brainboxemb/2026-009-01.cad.HUB75-display-frame/doc/README.md

# HUB75 display-frame documentation

This directory is the maintained project-documentation index.

## Reading order

- [10-00 — Plan](10-00-plan.md) — current gate, sequencing and project status.
- [20-00 — Manuals](20-00-manuals.md) — practical development and user guidance.
- [20-01 — Development](20-01-development.md) — maintain, qualify and release the project.
- [20-02 — User](20-02-user.md) — inspect/build the current display-frame.
- [30-00 — Specification](30-00-specification.md) — project intent and ownership.
- [40-00 — Design](40-00-design.md) — application architecture and coordinate model.
- [50-00 — Verification](50-00-verification.md) — digital/physical acceptance boundaries.

Detailed component construction remains beside source in component-local
`design/design.md` files. Physical procedures remain under
[../vrf/physical/](../vrf/physical/README.md).
