brainboxemb/2026-009-01.cad.HUB75-display-frame/vrf/templates/README.md

# HUB75 display-frame verification

Repository-level strategy/status: [30-verification.md](30-verification.md).

Verification evidence is deliberately separate from normal build output.

The build branch answers **what is built**. This verification branch answers
**whether the current connector-family geometry fits the HUB75 panel model as
intended**.

Normal standalone component renders and production STL exports remain under
`bld/` and are intentionally not duplicated in this snapshot. The verification
snapshot contains only fit/section evidence plus publication provenance.

## Contents

- [PNG verification gallery](png/README.md)

## Components

### Middle coupler

Joins two adjacent panels at the middle mounting row. Each small/medium/large
size publishes an angled local fit view, a size-aware rear fit section and an
XY seam section.

### Horizontal-edge coupler

Joins the same panel seam at the top/bottom display edge. The core fit evidence
remains intentionally independent of the tube-mount layer so physical panel
acceptance can still evaluate the accepted panel-facing geometry.

Each small/medium/large size publishes an angled top-edge fit detail, a
size-aware rear fit section, a YZ end-rail profile and an orthogonal XY seam
profile through the vertical arm.

### Corner-edge couplers

The corner family has two printable parts:

- left = top-left and, after 180 degree rotation, bottom-right;
- right = top-right and, after 180 degree rotation, bottom-left.

Each side and size publishes:

- angled one-panel corner fit detail;
- size-aware rear fit section through the rounded rear corner opening;
- a 0.10 mm YZ top-edge technical slice;
- a 0.10 mm XY side-edge technical slice.

In addition, each size publishes two canonical readable profile sections shared
by left/right because the two interfaces are mirrored equivalents:

- horizontal profile section through the top arm;
- vertical profile section through the side arm.

These canonical 0.50 mm profile sections retain the complete panel profile with
the red corner coupler around it, matching the presentation style used for the
horizontal-edge profile sections.

The core corner-fit evidence remains independent of the reinforcement layer.

### Tube-mount coupler and canonical clamp

The tube-mount layer uses one canonical separate printable tube clamp built from
the public `lib.scad.clamps` tube-clamp body plus the standard locked
sliding-dovetail interface from the pinned `lib.scad.mechint` revision.

For each small/medium/large coupler size, the same clamp is used and the
verification snapshot publishes:

- an assembled local view containing horizontal-edge tube-mount coupler,
  detachable clamp and Ø10 aluminium tube;
- a thin YZ section through the dovetail engagement, generated with
  `lib.scad.util`;
- a thin XY section through the integral threshold/recess/spring lock.

These views establish digital placement and engagement only. Sliding force,
printer/material tolerance and repeated removal remain physical checks.

## Selective verification

The OpenSCAD evidence above is built by the dependency-aware verification target
engine from `vrf/openscad`. It uses a cache separate from normal Build output, so
an unchanged middle or horizontal verification target can be reused when only a
corner dependency changes. The project-specific verification scripts retain only
interactive-entrypoint smoke checks, output validation and README generation.

## Rear fit sections

The section plane is kept inside the active guide: **3 mm** for the small
4 mm guide and **5 mm** for medium/large.

- grey = real HUB75 rear structural geometry;
- red = only coupler material reaching into the same retained volume;
- blue = Ø2 verification datum pin through the connector's engraved `+`,
  normal to the panel plane.

## Acceptance

These images are digital verification evidence, not proof of a physical print
fit. Production STLs are supplied by the normal Build and still need a real-panel
fit check before a connector-family milestone is considered physically accepted.
