brainboxemb/2026-009-01.cad.HUB75-display-frame/vrf/templates/png/README.md

# Connector verification renders

All verification renders use unique filenames so component and size variants
can be compared directly without navigating through separate directories.
Normal standalone component renders are intentionally kept in the Build output
instead of being duplicated here.

## Reading the section views

Project coordinates are:

| Axis | Direction |
| --- | --- |
| X | horizontal across the display |
| Y | panel front → rear |
| Z | vertical |

Section orientation follows the retained plane:

| Plane | Normal / section axis |
| --- | --- |
| XY | Z |
| YZ | X |
| XZ / rear-facing | Y |

Unless explicitly described as a retained volume, **position** below is the
centre of the section slab and **thickness** is the retained slab thickness.
The implementation may therefore use `position = centre - thickness / 2`
with `direction = "Positive"`.

The HUB75 rear mounting plane is at **Y = 14.50 mm**. Rear-fit positions are
described relative to that datum as well as by their absolute Y coordinate.

# Middle coupler

## Section geometry

| View | Orientation | Position | Thickness / depth | Purpose |
| --- | --- | --- | --- | --- |
| Rear fit — small | XZ, normal Y | cutoff Y = 11.50 mm | 3.00 mm inward from mounting plane; retained rear volume rather than a thin slice | Shows panel/coupler overlap behind the mounting plane |
| Rear fit — medium / large | XZ, normal Y | cutoff Y = 9.50 mm | 5.00 mm inward from mounting plane; retained rear volume rather than a thin slice | Same rear-interface check at the deeper guide presets |
| XY seam — small | XY, normal Z | centre Z ≈ -18.241 mm | 0.50 mm | Slice through the vertical seam below the horizontal arm |
| XY seam — medium | XY, normal Z | centre Z ≈ -20.241 mm | 0.50 mm | Same seam slice for the medium arm height |
| XY seam — large | XY, normal Z | centre Z ≈ -22.241 mm | 0.50 mm | Same seam slice for the large arm height |
| Angled fit | 3D view | — | — | Local visual fit context; not a section |

The middle XY position is derived from
`-hub75_middle_coupler_horizontal_arm_height(coupler) / 2 - 6 mm`, so it
tracks the selected coupler preset rather than using one hard-coded Z value.

## Small

Middle small rear fit

Middle small XY seam

Middle small angled fit

## Medium

Middle medium rear fit

Middle medium XY seam

Middle medium angled fit

## Large

Middle large rear fit

Middle large XY seam

Middle large angled fit

# Horizontal-edge coupler

## Section geometry

| View | Orientation | Position | Thickness | Purpose |
| --- | --- | --- | --- | --- |
| Rear fit — small | XZ, normal Y | centre Y = 11.50 mm | 0.10 mm | Thin rear-interface slice, 3 mm inward from the mounting plane |
| Rear fit — medium / large | XZ, normal Y | centre Y = 9.50 mm | 0.10 mm | Thin rear-interface slice, 5 mm inward from the mounting plane |
| YZ edge profile | YZ, normal X | centre X = 12.00 mm | 0.50 mm | Cross-section through the right panel rear end rail near the seam |
| XY seam profile | XY, normal Z | centre Z = 138.00 mm | 0.50 mm | Section 22 mm inward from the nominal top edge at Z = 160 mm |
| Angled fit | 3D view | — | — | Local visual fit context; not a section |

## Small

Horizontal edge small rear fit

Horizontal edge small YZ edge profile

Horizontal edge small XY seam profile

Horizontal edge small angled fit

## Medium

Horizontal edge medium rear fit

Horizontal edge medium YZ edge profile

Horizontal edge medium XY seam profile

Horizontal edge medium angled fit

## Large

Horizontal edge large rear fit

Horizontal edge large YZ edge profile

Horizontal edge large XY seam profile

Horizontal edge large angled fit

# Corner-edge couplers

## Section geometry

The canonical profile views use the left/top corner as their reference. The
left/right fit views then show the mirrored physical corner positions.

| View | Orientation | Position | Thickness | Purpose |
| --- | --- | --- | --- | --- |
| Canonical horizontal profile | YZ, normal X | centre X = -60.00 mm | 0.50 mm | 20 mm inward from the nominal left edge at X = -80 mm |
| Canonical vertical profile | XY, normal Z | centre Z = 140.00 mm | 0.50 mm | 20 mm inward from the nominal top edge at Z = 160 mm |
| Rear fit — small | XZ, normal Y | centre Y = 11.50 mm | 0.10 mm | Thin corner rear-fit slice, 3 mm inward from mounting plane |
| Rear fit — medium / large | XZ, normal Y | centre Y = 9.50 mm | 0.10 mm | Thin corner rear-fit slice, 5 mm inward from mounting plane |
| Left YZ top-edge | YZ, normal X | centre X = -60.00 mm | 0.10 mm | 20 mm inward from the top-left corner |
| Right YZ top-edge | YZ, normal X | centre X = +60.00 mm | 0.10 mm | Mirrored 20 mm inward slice at the top-right corner |
| Left / right XY side-edge | XY, normal Z | centre Z = 140.00 mm | 0.10 mm | 20 mm inward from the top edge |
| Angled fit | 3D view | — | — | Local visual corner-fit context; not a section |

## Small

### Canonical profiles

Corner small horizontal profile

Corner small vertical profile

### Left

Corner left small rear fit

Corner left small YZ top-edge slice

Corner left small XY side-edge slice

Corner left small angled fit

### Right

Corner right small rear fit

Corner right small YZ top-edge slice

Corner right small XY side-edge slice

Corner right small angled fit

## Medium

### Canonical profiles

Corner medium horizontal profile

Corner medium vertical profile

### Left

Corner left medium rear fit

Corner left medium YZ top-edge slice

Corner left medium XY side-edge slice

Corner left medium angled fit

### Right

Corner right medium rear fit

Corner right medium YZ top-edge slice

Corner right medium XY side-edge slice

Corner right medium angled fit

## Large

### Canonical profiles

Corner large horizontal profile

Corner large vertical profile

### Left

Corner left large rear fit

Corner left large YZ top-edge slice

Corner left large XY side-edge slice

Corner left large angled fit

### Right

Corner right large rear fit

Corner right large YZ top-edge slice

Corner right large XY side-edge slice

Corner right large angled fit

# Tube-mount coupler and canonical clamp

The clamp is one canonical part for all three coupler presets. The section
position changes only because the small coupler uses a different clamp location.

## Section geometry

| View | Orientation | Position | Thickness | Purpose |
| --- | --- | --- | --- | --- |
| Clamp fit | 3D view | clamp centre X = 18 mm small; 25 mm medium / large | — | Shows the complete local tube-mount, clamp and Ø10 aluminium tube |
| YZ dovetail section — small | YZ, normal X | centre X = 18.00 mm | 0.20 mm | Section through the centre of the local dovetail engagement |
| YZ dovetail section — medium / large | YZ, normal X | centre X = 25.00 mm | 0.20 mm | Same section at the common medium/large clamp position |
| XY lock section | XY, normal Z | centre Z = 10.00 mm | 0.20 mm | Shows the lib.scad.mechint ramped threshold, male recess/release and female spring tongue |

The implementation starts these 0.20 mm slabs half a section thickness before
the listed centre and retains them in the positive section-axis direction.

## Small

Small tube-mount coupler with canonical clamp

Small tube-mount coupler YZ section

Small tube-mount coupler lock section

## Medium

Medium tube-mount coupler with canonical clamp

Medium tube-mount coupler YZ section

Medium tube-mount coupler lock section

## Large

Large tube-mount coupler with canonical clamp

Large tube-mount coupler YZ section

Large tube-mount coupler lock section
