brainboxemb/2026-009-01.cad.HUB75-display-frame/docs/01-project-plan.md

# HUB75 display-frame project plan

The project plan moved to [../doc/00-plan.md](../doc/00-plan.md) during
Migration 010 so the project has one operational plan authority.
This file remains only as a compatibility pointer for older links.
