brainboxemb/2026-009-01.cad.HUB75-display-frame/docs/00-new-chat-handoff.md

# New chat / project handoff

This historical entrypoint is retained for compatibility.
Start with [../doc/00-plan.md](../doc/00-plan.md), which now owns the durable
fresh-session working method, current project position and forward plan.

Shared working guidance comes from
[brainboxemb.meta/AGENTS.md](https://github.com/brainboxemb/brainboxemb.meta/blob/main/AGENTS.md).
Do not maintain a second copy/paste workflow here.
