brainboxemb/2026-009-01.cad.HUB75-display-frame/vrf/openscad/corner-edge-coupler-horizontal-profile-section.scad

// Canonical YZ profile through the top/horizontal corner arm.

use <../../dsg/openscad/assemblies/verification/corner_edge_coupler_profile_sections.scad>
use <../../dsg/openscad/ext/lib.scad.hub75/openscad/p5-64x32-panel/hub75_p5_64x32_panel.scad>
use <../../dsg/openscad/components/hub75/corner-edge-coupler/hub75_corner_edge_coupler.scad>

size = "medium";
side = "left";

panel_obj = hub75_p5_64x32_panel_create();
coupler_obj = hub75_corner_edge_coupler_create_for_size(
    side = side,
    size = size,
    panel_obj = panel_obj
);
corner_x = -hub75_p5_64x32_panel_nominal_width(panel_obj) / 2;
corner_z = hub75_p5_64x32_panel_nominal_height(panel_obj) / 2;
slice_inward = 20;
slice_x = corner_x + slice_inward;

$vpt = [slice_x, 7, corner_z - 35];
$vpr = [0, 90, 0];
$vpd = 205;

hub75_corner_edge_coupler_horizontal_profile_section(
    side = side,
    panel_obj = panel_obj,
    coupler_obj = coupler_obj,
    slice_inward = slice_inward
);
