brainboxemb/2026-009-01.cad.HUB75-display-frame/vrf/openscad/corner-edge-coupler-left-rear-fit-section.scad

// Rear-facing top-left corner fit section.

use <../../dsg/openscad/assemblies/verification/corner_edge_coupler_fit_assembly.scad>
use <../../dsg/openscad/ext/lib.scad.hub75/openscad/p5-64x32-panel/hub75_p5_64x32_panel.scad>
use <../../dsg/openscad/components/hub75/corner-edge-coupler/hub75_corner_edge_coupler.scad>

size = "medium";

panel_obj = hub75_p5_64x32_panel_create();
coupler_obj =
    hub75_corner_edge_coupler_create_for_size(
        side = "left",
        size = size,
        panel_obj = panel_obj
    );

section_depth =
    min(5.0, max(1.0, coupler_obj.guide_height - 1.0));

corner_x =
    -hub75_p5_64x32_panel_nominal_width(panel_obj) / 2;
corner_z =
    hub75_p5_64x32_panel_nominal_height(panel_obj) / 2;

// Centre on the complete coupler, including its outside projection.
view_inward = (hub75_corner_edge_coupler_inward_reach(coupler_obj)
    - coupler_obj.outside_projection) / 2;
$vpt = [corner_x + view_inward, 9.5, corner_z - view_inward];
$vpr = [90, 0, 180];
$vpd =
    size == "small" ? 190
    : size == "large" ? 255
    : 220;

hub75_corner_edge_coupler_rear_fit_section(
    side = "left",
    panel_obj = panel_obj,
    coupler_obj = coupler_obj,
    depth = section_depth
);
