brainboxemb/2026-009-01.cad.HUB75-display-frame/vrf/openscad/corner-edge-coupler-right-xy-side-edge-section.scad

// XY side-edge fit section for the top-right corner.

use <../../dsg/openscad/assemblies/verification/corner_edge_coupler_fit_assembly.scad>
use <../../dsg/openscad/ext/lib.scad.hub75/openscad/p5-64x32-panel/hub75_p5_64x32_panel.scad>
use <../../dsg/openscad/components/hub75/corner-edge-coupler/hub75_corner_edge_coupler.scad>

size = "medium";
side = "right";

panel_obj = hub75_p5_64x32_panel_create();
coupler_obj = hub75_corner_edge_coupler_create_for_size(side = side, size = size, panel_obj = panel_obj);
corner_x = (1) * hub75_p5_64x32_panel_nominal_width(panel_obj) / 2;
corner_z = hub75_p5_64x32_panel_nominal_height(panel_obj) / 2;
slice_inward = 20;
slice_z = corner_z - slice_inward;

$vpt = [corner_x + (-1) * 20, 7, slice_z];
$vpr = [0, 0, 0];
$vpd = size == "small" ? 150 : size == "large" ? 215 : 180;

hub75_corner_edge_coupler_xy_side_edge_section(
    side = side,
    panel_obj = panel_obj,
    coupler_obj = coupler_obj,
    slice_inward = slice_inward,
    slice_thickness = 0.10
);
