brainboxemb/2026-009-01.cad.HUB75-display-frame/vrf/openscad/horizontal-edge-coupler-fit-detail.scad

// Angled two-panel top-edge context for horizontal-edge verification.

use <../../dsg/openscad/assemblies/verification/horizontal_edge_coupler_fit_assembly.scad>
use <../../dsg/openscad/components/hub75/horizontal-edge-coupler/hub75_horizontal_edge_coupler.scad>

size = "medium";

$vpt = [0, 14, 115];
$vpr = [78, 0, 220];
$vpd = 260;

coupler_obj =
    hub75_horizontal_edge_coupler_create_for_size(
        size = size
    );

hub75_horizontal_edge_coupler_fit_detail(
    coupler_obj = coupler_obj
);
