brainboxemb/2026-009-01.cad.HUB75-display-frame/vrf/openscad/horizontal-edge-tube-mount-clamp-fit.scad

// Focused assembled view of a tube-mount coupler with the canonical clamp.

use <../../dsg/openscad/assemblies/verification/hub75_tube_horizontal_edge_fit_assembly.scad>

size = "medium";

$vpt = [28, -2, 8];
$vpr = [68, 0, 35];
$vpd = 125;

hub75_tube_horizontal_edge_fit_assembly(
    size = size
);
