brainboxemb/2026-009-01.cad.HUB75-display-frame/vrf/openscad/middle-coupler-rear-fit-section.scad

// File: middle-coupler-rear-fit-section.scad
//   Rear-facing 5 mm fit section through the panel/coupler interface.

use <../../dsg/openscad/assemblies/verification/middle_coupler_fit_assembly.scad>
use <../../dsg/openscad/components/hub75/middle-coupler/hub75_middle_coupler.scad>

size = "medium";

$vpt = [0, 9.5, 0];
$vpr = [90, 0, 180];
$vpd = 210;

coupler_obj = hub75_middle_coupler_create_for_size(size = size);
section_depth =
    min(5.0, max(1.0, coupler_obj.guide_height - 1.0));

hub75_middle_coupler_rear_fit_section(
    coupler_obj = coupler_obj,
    depth = section_depth
);
