brainboxemb/2026-009-01.cad.HUB75-display-frame/vrf/openscad/middle-coupler-xy-seam-section.scad

// File: middle-coupler-xy-seam-section.scad
//   True XY section below the horizontal rib, through the seam locator.

use <../../dsg/openscad/assemblies/verification/middle_coupler_fit_assembly.scad>
use <../../dsg/openscad/components/hub75/middle-coupler/hub75_middle_coupler.scad>

size = "medium";

$vpt = [0, 7, -20];
$vpr = [0, 0, 0];
$vpd = 185;

coupler_obj = hub75_middle_coupler_create_for_size(size = size);
hub75_middle_coupler_fit_cross_section(coupler_obj = coupler_obj);
