brainboxemb/2026-009-01.cad.HUB75-display-frame/dsg/openscad/assemblies/display_frame_assembly.scad

// File: display_frame_assembly.scad
//   Complete display overview with couplers and detachable tube-mount layer.

use <../ext/lib.scad.hub75/openscad/p5-64x32-panel/hub75_p5_64x32_panel.scad>
use <../ext/lib.scad.forge/openscad/resolution.scad>
use <../ext/lib.scad.forge/openscad/transform.scad>
use <../components/aluminium_tube.scad>
use <panels_assembly.scad>
use <helpers/reference_box.scad>
use <../components/hub75/middle-coupler/hub75_middle_coupler.scad>
use <../components/hub75/horizontal-edge-coupler/hub75_horizontal_edge_coupler.scad>
use <../components/hub75/corner-edge-coupler/hub75_corner_edge_coupler.scad>
use <../project_components/tube_mount/horizontal-edge-coupler/hub75_tube_horizontal_edge_coupler.scad>
use <../project_components/tube_mount/corner-edge-coupler/hub75_tube_corner_edge_coupler.scad>
use <../project_components/tube_mount/tube-clamp/hub75_tube_clamp.scad>
use <../project_components/tube_mount/tube_mount_interface.scad>

function _hub75_display_frame_panel_pitch_x(panel_obj) =
    hub75_p5_64x32_panel_nominal_width(panel_obj);

function _hub75_display_frame_half_height(panel_obj) =
    hub75_p5_64x32_panel_nominal_height(panel_obj) / 2;

function _hub75_display_frame_half_width(panel_obj, panel_count = 5) =
    panel_count * _hub75_display_frame_panel_pitch_x(panel_obj) / 2;

function _hub75_display_frame_seam_x(panel_obj, seam_index, panel_count = 5) =
    -_hub75_display_frame_half_width(panel_obj, panel_count)
    + (seam_index + 1) * _hub75_display_frame_panel_pitch_x(panel_obj);

function hub75_display_frame_reference_width(panel_obj, panel_count = 5) =
    panel_count * hub75_p5_64x32_panel_nominal_width(panel_obj) + 40;

function hub75_display_frame_reference_height(panel_obj) =
    hub75_p5_64x32_panel_nominal_height(panel_obj) + 40;

function hub75_display_frame_tube_length(panel_obj, panel_count = 5) =
    hub75_display_frame_reference_width(panel_obj, panel_count);

module _hub75_display_frame_middle_couplers(
    panel_obj,
    coupler_obj,
    panel_count,
    mounting_y,
    coupler_color
) {
    color(coupler_color)
        for (seam_index = [0 : panel_count - 2])
            fg_xf_move([
                _hub75_display_frame_seam_x(panel_obj, seam_index, panel_count),
                mounting_y,
                0
            ])
                hub75_middle_coupler_build(coupler_obj);
}

module _hub75_display_frame_horizontal_edge_couplers(
    panel_obj,
    coupler_obj,
    panel_count,
    mounting_y,
    coupler_color,
    tube_mount_enabled,
    resolution
) {
    edge_z = _hub75_display_frame_half_height(panel_obj);

    color(coupler_color)
        for (seam_index = [0 : panel_count - 2]) {
            seam_x =
                _hub75_display_frame_seam_x(panel_obj, seam_index, panel_count);

            fg_xf_move([seam_x, mounting_y, edge_z])
                if (tube_mount_enabled)
                    hub75_tube_horizontal_edge_coupler_build(coupler_obj, resolution = resolution);
                else
                    hub75_horizontal_edge_coupler_build(coupler_obj);

            fg_xf_move([seam_x, mounting_y, -edge_z])
                fg_xf_yrot(180)
                    if (tube_mount_enabled)
                        hub75_tube_horizontal_edge_coupler_build(coupler_obj, resolution = resolution);
                    else
                        hub75_horizontal_edge_coupler_build(coupler_obj);
        }
}

module _hub75_display_frame_corner_couplers(
    panel_obj,
    left_coupler_obj,
    right_coupler_obj,
    panel_count,
    mounting_y,
    coupler_color,
    tube_mount_enabled,
    resolution
) {
    edge_x = _hub75_display_frame_half_width(panel_obj, panel_count);
    edge_z = _hub75_display_frame_half_height(panel_obj);

    color(coupler_color) {
        fg_xf_move([-edge_x, mounting_y, edge_z])
            if (tube_mount_enabled)
                hub75_tube_corner_edge_coupler_build(left_coupler_obj, resolution = resolution);
            else
                hub75_corner_edge_coupler_build(left_coupler_obj);

        fg_xf_move([edge_x, mounting_y, edge_z])
            if (tube_mount_enabled)
                hub75_tube_corner_edge_coupler_build(right_coupler_obj, resolution = resolution);
            else
                hub75_corner_edge_coupler_build(right_coupler_obj);

        fg_xf_move([edge_x, mounting_y, -edge_z])
            fg_xf_yrot(180)
                if (tube_mount_enabled)
                    hub75_tube_corner_edge_coupler_build(left_coupler_obj, resolution = resolution);
                else
                    hub75_corner_edge_coupler_build(left_coupler_obj);

        fg_xf_move([-edge_x, mounting_y, -edge_z])
            fg_xf_yrot(180)
                if (tube_mount_enabled)
                    hub75_tube_corner_edge_coupler_build(right_coupler_obj, resolution = resolution);
                else
                    hub75_corner_edge_coupler_build(right_coupler_obj);
    }
}

module _hub75_display_frame_tube_clamps(
    panel_obj,
    horizontal_coupler_obj,
    left_coupler_obj,
    right_coupler_obj,
    panel_count,
    mounting_y,
    clamp_color,
    resolution
) {
    edge_x = _hub75_display_frame_half_width(panel_obj, panel_count);
    edge_z = _hub75_display_frame_half_height(panel_obj);

    horizontal_positions =
        hub75_tube_horizontal_edge_clamp_positions_mm(horizontal_coupler_obj);
    left_x = hub75_tube_corner_edge_clamp_x_mm(left_coupler_obj);
    right_x = hub75_tube_corner_edge_clamp_x_mm(right_coupler_obj);

    horizontal_clamp_obj =
        hub75_tube_clamp_create(
            dovetail_obj =
                hub75_tube_mount_dovetail_create(
                    host_depth_mm = horizontal_coupler_obj.base_thickness
                )
        );
    left_clamp_obj =
        hub75_tube_clamp_create(
            dovetail_obj =
                hub75_tube_mount_dovetail_create(
                    host_depth_mm = left_coupler_obj.base_thickness
                )
        );
    right_clamp_obj =
        hub75_tube_clamp_create(
            dovetail_obj =
                hub75_tube_mount_dovetail_create(
                    host_depth_mm = right_coupler_obj.base_thickness
                )
        );

    for (seam_index = [0 : panel_count - 2]) {
        seam_x =
            _hub75_display_frame_seam_x(panel_obj, seam_index, panel_count);

        for (clip_x = horizontal_positions) {
            fg_xf_move([seam_x + clip_x, mounting_y, edge_z])
                hub75_tube_clamp_build(
                    horizontal_clamp_obj,
                    part_color = clamp_color,
                    use_tension_bore = false,
                    resolution = resolution
                );

            fg_xf_move([seam_x - clip_x, mounting_y, -edge_z])
                fg_xf_yrot(180)
                    hub75_tube_clamp_build(
                        horizontal_clamp_obj,
                        part_color = clamp_color,
                        use_tension_bore = false,
                        resolution = resolution
                    );
        }
    }

    fg_xf_move([-edge_x + left_x, mounting_y, edge_z])
        hub75_tube_clamp_build(
            left_clamp_obj,
            part_color = clamp_color,
            use_tension_bore = false,
            resolution = resolution
        );

    fg_xf_move([edge_x + right_x, mounting_y, edge_z])
        hub75_tube_clamp_build(
            right_clamp_obj,
            part_color = clamp_color,
            use_tension_bore = false,
            resolution = resolution
        );

    fg_xf_move([edge_x - left_x, mounting_y, -edge_z])
        fg_xf_yrot(180)
            hub75_tube_clamp_build(
                left_clamp_obj,
                part_color = clamp_color,
                use_tension_bore = false,
                resolution = resolution
            );

    fg_xf_move([-edge_x - right_x, mounting_y, -edge_z])
        fg_xf_yrot(180)
            hub75_tube_clamp_build(
                right_clamp_obj,
                part_color = clamp_color,
                use_tension_bore = false,
                resolution = resolution
            );
}

module _hub75_display_frame_aluminium_tubes(
    panel_obj,
    panel_count,
    mounting_y,
    resolution,
    top_z_shift = 0,
    bottom_z_shift = 0,
    tube_color = [0.72, 0.74, 0.76, 1]
) {
    edge_z = _hub75_display_frame_half_height(panel_obj);
    length = hub75_display_frame_tube_length(panel_obj, panel_count);
    x_min = -length / 2;
    clamp_obj = hub75_tube_clamp_create();
    tube_obj =
        aluminium_tube_create(
            length_mm = length,
            outer_diameter_mm = clamp_obj.base_clamp.tube_diameter,
            wall_thickness_mm = 1
        );
    tube_y =
        mounting_y
        + hub75_tube_clamp_tube_center_y_mm(clamp_obj);
    tube_z =
        edge_z
        + hub75_tube_clamp_tube_center_z_mm(clamp_obj);

    color(tube_color) {
        fg_xf_move([x_min, tube_y, tube_z + top_z_shift])
            aluminium_tube_build(tube_obj, resolution = resolution);

        fg_xf_move([x_min, tube_y, -tube_z + bottom_z_shift])
            aluminium_tube_build(tube_obj, resolution = resolution);
    }
}

module _hub75_display_frame_debug_reference(panel_obj, panel_count) {
    width = hub75_display_frame_reference_width(panel_obj, panel_count);
    height = hub75_display_frame_reference_height(panel_obj);

    hub75_reference_box_wireframe(
        x_min = -width / 2,
        x_max = width / 2,
        y_min = 0,
        y_max = hub75_p5_64x32_panel_mounting_plane_y(panel_obj),
        z_min = -height / 2,
        z_max = height / 2
    );
}

module hub75_display_frame_assembly(
    panel_obj = hub75_p5_64x32_panel_create(),
    coupler_size = "medium",
    panel_count = 5,
    panel_color_scheme = "light_gray",
    panel_view = hub75_p5_64x32_panel_view_id("final"),
    coupler_color = [0.72, 0.05, 0.04, 1],
    clamp_color = [0.92, 0.20, 0.08, 1],
    tube_color = [0.72, 0.74, 0.76, 1],
    resolution = FG_RES_HIGH(),
    panels_visible = true,
    panel_numbers_visible = false,
    in_out_labels_visible = false,
    middle_couplers_visible = true,
    horizontal_edge_couplers_visible = true,
    corner_edge_couplers_visible = true,
    // WIP feature gate. Standard HUB75 couplers remain the assembly default.
    tube_mount_enabled = false,
    tube_clamps_visible = true,
    aluminium_tubes_visible = true,
    debug_reference_visible = false,
    explode_distance = 0,
    middle_coupler_obj = undef,
    horizontal_coupler_obj = undef,
    left_corner_coupler_obj = undef,
    right_corner_coupler_obj = undef
) {
    assert(explode_distance >= 0, "explode_distance must be >= 0");

    hub75_display_verify_nominal_size(
        panel_obj = panel_obj,
        panel_count = panel_count
    );

    active_middle_coupler_obj =
        is_undef(middle_coupler_obj)
            ? hub75_middle_coupler_create_for_size(
                size = coupler_size,
                panel_obj = panel_obj
            )
            : middle_coupler_obj;
    active_horizontal_coupler_obj =
        is_undef(horizontal_coupler_obj)
            ? hub75_horizontal_edge_coupler_create_for_size(
                size = coupler_size,
                panel_obj = panel_obj
            )
            : horizontal_coupler_obj;
    active_left_corner_coupler_obj =
        is_undef(left_corner_coupler_obj)
            ? hub75_corner_edge_coupler_create_for_size(
                side = "left",
                size = coupler_size,
                panel_obj = panel_obj
            )
            : left_corner_coupler_obj;
    active_right_corner_coupler_obj =
        is_undef(right_corner_coupler_obj)
            ? hub75_corner_edge_coupler_create_for_size(
                side = "right",
                size = coupler_size,
                panel_obj = panel_obj
            )
            : right_corner_coupler_obj;

    exploded = explode_distance > 0;
    panel_y_shift = exploded ? -explode_distance : 0;
    coupler_y_shift = exploded ? explode_distance : 0;
    clamp_y_shift = exploded ? 2 * explode_distance : 0;
    tube_y_shift = clamp_y_shift;
    tube_z_gap = exploded ? 0.55 * explode_distance : 0;

    base_mounting_y =
        hub75_p5_64x32_panel_mounting_plane_y(panel_obj);
    coupler_mounting_y =
        base_mounting_y + coupler_y_shift;
    clamp_mounting_y =
        base_mounting_y + clamp_y_shift;
    tube_mounting_y =
        base_mounting_y + tube_y_shift;

    if (panels_visible)
        fg_xf_move([0, panel_y_shift, 0])
            hub75_panels_assembly(
                panel_obj = panel_obj,
                panel_count = panel_count,
                color_scheme = panel_color_scheme,
                panel_view = panel_view,
                panel_numbers_visible = panel_numbers_visible,
                in_out_labels_visible = in_out_labels_visible
            );

    if (middle_couplers_visible)
        _hub75_display_frame_middle_couplers(
            panel_obj,
            active_middle_coupler_obj,
            panel_count,
            coupler_mounting_y,
            coupler_color
        );

    if (horizontal_edge_couplers_visible)
        _hub75_display_frame_horizontal_edge_couplers(
            panel_obj,
            active_horizontal_coupler_obj,
            panel_count,
            coupler_mounting_y,
            coupler_color,
            tube_mount_enabled,
            resolution
        );

    if (corner_edge_couplers_visible)
        _hub75_display_frame_corner_couplers(
            panel_obj,
            active_left_corner_coupler_obj,
            active_right_corner_coupler_obj,
            panel_count,
            coupler_mounting_y,
            coupler_color,
            tube_mount_enabled,
            resolution
        );

    if (tube_mount_enabled && tube_clamps_visible)
        _hub75_display_frame_tube_clamps(
            panel_obj,
            active_horizontal_coupler_obj,
            active_left_corner_coupler_obj,
            active_right_corner_coupler_obj,
            panel_count,
            clamp_mounting_y,
            clamp_color,
            resolution
        );

    if (tube_mount_enabled && aluminium_tubes_visible)
        _hub75_display_frame_aluminium_tubes(
            panel_obj,
            panel_count,
            tube_mounting_y,
            resolution,
            top_z_shift = tube_z_gap,
            bottom_z_shift = -tube_z_gap,
            tube_color = tube_color
        );

    if (debug_reference_visible)
        _hub75_display_frame_debug_reference(panel_obj, panel_count);
}
