brainboxemb/2026-009-01.cad.HUB75-display-frame/dsg/openscad/export/corner-edge-coupler-left.scad

// STL export entrypoint for the left corner-edge coupler.

use <../components/hub75/corner-edge-coupler/hub75_corner_edge_coupler.scad>
use <../export_support/export_orientation.scad>

// tool.scad-project multi-size adapter: overridden by -D size=...
size = "medium";
d_profile = size;

coupler_obj =
    hub75_corner_edge_coupler_create_for_size(
        side = "left",
        size = d_profile
    );

expected_profile =
    d_profile == "small" ? [60, 2, 4, 2]
    : d_profile == "large" ? [100, 6, 10, 4]
    : [80, 4, 6, 3];

expected_horizontal_arm =
    d_profile == "small" ? 14.0011328125
    : d_profile == "large" ? 22.0011328125
    : 18.0011328125;

expected_vertical_arm =
    d_profile == "small" ? 15.75234375
    : d_profile == "large" ? 23.75234375
    : 19.75234375;

expected_screw_x =
    "left" == "left" ? 8 : -8;

assert(
    abs(coupler_obj.profile_size - expected_profile[0]) < 0.001
    && abs(coupler_obj.wall_thickness - expected_profile[1]) < 0.001
    && abs(coupler_obj.guide_height - expected_profile[2]) < 0.001
    && abs(coupler_obj.base_thickness - expected_profile[3]) < 0.001,
    "Corner-edge size preset changed"
);

assert(
    abs(coupler_obj.outside_projection - 19.5) < 0.001,
    "Corner-edge outside projection changed"
);

assert(
    abs(coupler_obj.screw_x - expected_screw_x) < 0.001
    && abs(coupler_obj.screw_z + 8.0) < 0.001,
    "Corner-edge screw position changed"
);

assert(
    abs(
        hub75_corner_edge_coupler_side_rail_center_x(coupler_obj)
        - ("left" == "left" ? 7.023828125 : -7.023828125)
    ) < 0.001,
    "Corner-edge side-rail centre derivation changed"
);

assert(
    abs(
        hub75_corner_edge_coupler_end_rail_center_z(coupler_obj)
        + 6.14443359375
    ) < 0.001,
    "Corner-edge end-rail centre derivation changed"
);

assert(
    abs(
        hub75_corner_edge_coupler_horizontal_arm_height(coupler_obj)
        - expected_horizontal_arm
    ) < 0.001,
    "Corner-edge horizontal arm derivation changed"
);

assert(
    abs(
        hub75_corner_edge_coupler_vertical_arm_width(coupler_obj)
        - expected_vertical_arm
    ) < 0.001,
    "Corner-edge vertical arm derivation changed"
);

assert(
    abs(coupler_obj.screw_relief_depth - 0.20) < 0.001
    && abs(coupler_obj.screw_relief_radial - 0.40) < 0.001,
    "Corner-edge screw relief changed"
);

assert(
    abs(
        hub75_corner_edge_coupler_reference_pocket_effective_depth(coupler_obj)
        - (d_profile == "small" ? 1.3 : 2.0)
    ) < 0.001,
    "Corner-edge reference pocket depth changed"
);

assert(
    abs(
        hub75_corner_edge_coupler_reinforcement_locator_pad_diameter(coupler_obj)
        - 9.4
    ) < 0.001
    &&
    abs(
        hub75_corner_edge_coupler_reinforcement_locator_pin_diameter(coupler_obj)
        - 2.1
    ) < 0.001,
    "Corner-edge reinforcement locator derivation changed"
);

assert(
    hub75_corner_edge_coupler_has_locator_pin(coupler_obj)
        == ("left" == "left"),
    "Corner-edge locator-pin chirality changed"
);

if ("left" == "left") {
    locator =
        hub75_corner_edge_coupler_locator_pin_position(coupler_obj);

    assert(
        abs(locator[0] - 5.0) < 0.001
        && abs(locator[1] + 50.0) < 0.001,
        "Top-left locator-pin position changed"
    );
}

hub75_export_rear_face_down(coupler_obj.base_thickness)
    hub75_corner_edge_coupler_build(coupler_obj);
