brainboxemb/2026-009-01.cad.HUB75-display-frame/dsg/openscad/export/dovetail-tube-clamp.scad

// STL export entrypoint for the size-matched detachable dovetail tube clamp.

use <../ext/lib.scad.forge/openscad/resolution.scad>
use <../project_components/tube_mount/tube-clamp/hub75_tube_clamp.scad>
use <../export_support/export_orientation.scad>

// tool.scad-project multi-size adapter: overridden by -D size=...
size = "medium";
d_profile = size;
_clamp_obj = hub75_tube_clamp_create_for_size(d_profile);

hub75_export_clamp_side_down(_clamp_obj.base_clamp.clamp_width)
    hub75_tube_clamp_build(
        _clamp_obj,
        resolution = FG_RES_EXPORT()
    );
