brainboxemb/2026-009-01.cad.HUB75-display-frame/dsg/openscad/assemblies/verification/hub75_tube_horizontal_edge_fit_assembly.scad

// File: hub75_tube_horizontal_edge_fit_assembly.scad
//   Focused verification wrapper around the real horizontal tube-mount
//   subassembly.

use <../../ext/lib.scad.forge/openscad/resolution.scad>
use <../sub/hub75_tube_horizontal_edge_assembly.scad>

module hub75_tube_horizontal_edge_fit_assembly(
    size = "medium",
    show_coupler = true,
    show_clamp = true,
    show_tube = true,
    explode_distance = 0,
    resolution = FG_RES_HIGH()
) {
    hub75_tube_horizontal_edge_assembly(
        size = size,
        show_coupler = show_coupler,
        show_clamps = show_clamp,
        show_tube = show_tube,
        explode_distance = explode_distance,
        resolution = resolution
    );
}
