brainboxemb/2026-009-01.cad.HUB75-display-frame/dsg/openscad/components/hub75/middle-coupler/hub75_middle_coupler.scad

// File: hub75_middle_coupler.scad
//   Project-specific middle coupler for two adjacent portrait HUB75 panels.
//
// - Design: design/design.md
// - Design review: hub75_middle_coupler_render.scad
//
// Physical role:
// - local X=0 is the nominal seam between the two panels;
// - local Y=0 is the panel-facing surface of the coupler base;
// - local Z=0 is the middle HUB75 mounting-hole row;
// - the base extends toward +Y, behind the display;
// - guides and the seam locator extend toward -Y, into the rear panel geometry.
//
// The reusable HUB75 library is the authority for panel mating dimensions.
// This component owns only printable coupler choices.

use <../../../ext/lib.scad.forge/openscad/resolution.scad>
use <../../../ext/lib.scad.forge/openscad/transform.scad>
use <../../../ext/lib.scad.forge/openscad/cutter.scad>
use <../../../ext/lib.scad.forge/openscad/csg.scad>
use <../../../ext/lib.scad.hub75/openscad/p5-64x32-panel/hub75_p5_64x32_panel.scad>
use <../hub75_panel_mating.scad>

/* [Core profile] */
d_profile_size_mm = 80;
d_wall_thickness_mm = 4;
d_fit_clearance_mm = 0.25;
d_base_thickness_mm = 3;
d_guide_height_mm = 6;
d_inside_corner_radius_mm = 10;
d_outside_corner_radius_mm = 6;
d_guide_end_rounding_mm = 1.5;

/* [Mounting] */
d_screw_hole_diameter_mm = 3.4;
d_screw_relief_depth_mm = 0.20;
d_screw_relief_radial_mm = 0.40;
d_mounting_tube_radial_clearance_mm = 0.45;
d_mounting_tube_axial_clearance_mm = 0.40;
d_reinforcement_bushing_clearance_mm = 0.45;
d_reinforcement_locator_pad_radial_clearance_mm = 0.30;
d_reinforcement_locator_pad_axial_clearance_mm = 0.10;
d_reinforcement_locator_pin_radial_clearance_mm = 0.20;
d_reinforcement_locator_pin_length_mm = 2.0;

/* [Surface reference details] */
d_show_reference_pockets = true;
d_reference_pocket_diameter_mm = 3.0;
d_reference_pocket_depth_mm = 2.0;
d_reference_pocket_min_back_wall_mm = 0.7;
d_reference_pocket_end_diameter_mm = 2.0;
d_reference_pocket_taper_depth_mm = 0.5;
d_reference_pocket_pitch_mm = 10.0;
d_reference_pocket_steps = [2, 3, 4];
d_reference_pocket_lane_grid_mm = 2.5;
d_reference_pocket_lane_fraction = 0.25;
d_reference_pocket_edge_margin_mm = 4.0;

d_show_center_reference_marks = true;
d_center_mark_depth_mm = 0.40;
d_center_mark_pitch_mm = 10.0;
d_center_mark_major_length_mm = 4.0;
d_center_mark_minor_length_mm = 2.2;
d_center_mark_width_mm = 0.8;
d_center_mark_cross_length_mm = 6.0;
d_center_mark_edge_margin_mm = 4.0;
d_center_mark_screw_keepout_mm = 3.0;

/* [Seam locator] */
d_seam_locator_height_mm = 4;
d_seam_locator_end_radius_mm = 1.00;

/* [Preview] */
c_view = "final"; // [final,functional,profile,base,screw-holes,tube-pockets,guides,reinforcement-locators,seam-locator,reference-pockets,center-marks]

/* [Resolution] */
c_resolution = "high"; // [low,high,export]

_standalone_render_fn =
    c_resolution == FG_RES_LOW()
        ? 48
        : 192;

_HUB75_MIDDLE_COUPLER_EPS = 0.05;


// ----------------------------------------------------------------------
// Public object API
// ----------------------------------------------------------------------

// Function: hub75_middle_coupler_create()
// Description:
//   Creates one middle-coupler object. Panel-dependent mating dimensions are
//   captured through the public lib.scad.hub75 API; project code should not
//   duplicate those panel dimensions.
// Arguments:
//   panel_obj = HUB75 panel object that defines the mating geometry.
//   profile_size = Overall X/Z extent of the PLUS plate.
//   wall_thickness = Printed material beside the fitted panel rib keep-out.
//   fit_clearance = Printable clearance per side around HUB75 rear geometry.
//   base_thickness = Coupler plate thickness behind the panel mounting plane.
//   guide_height = Guide-wall insertion depth toward the panel.
//   inside_corner_radius = Concave PLUS-profile corner radius.
//   outside_corner_radius = Convex free-end corner radius.
//   guide_end_rounding = Rounding applied to exposed raised-guide endpoints.
//   render_fn = Facet count used by all curved production geometry.
//   screw_hole_diameter = Through-hole diameter for the two mounting screws.
//   screw_relief_* = Shallow cylindrical anti-elephant-foot relief at both
//     base-plate faces.
//   reinforcement_locator_* = Printable clearances for the positive pad/pin
//     locators that enter the panel reinforcement recesses.
//   reference_pocket_* = Blind surface-pocket pattern parameters. The visible
//     Ø3 bore stays cylindrical before a short taper narrows the pocket bottom;
//     minimum back-wall thickness limits depth on thin presets.
//   center_mark_* = Shallow centre cross and 5/10 mm reference tick parameters.
function hub75_middle_coupler_create(
    panel_obj = hub75_p5_64x32_panel_create(),
    profile_size = 80,
    wall_thickness = 4,
    fit_clearance = 0.25,
    base_thickness = 3,
    guide_height = 6,
    inside_corner_radius = 10,
    outside_corner_radius = 6,
    guide_end_rounding = 1.5,
    render_fn = 192,
    screw_hole_diameter = 3.4,
    screw_relief_depth = 0.20,
    screw_relief_radial = 0.40,
    mounting_tube_radial_clearance = 0.45,
    mounting_tube_axial_clearance = 0.40,
    reinforcement_bushing_clearance = 0.45,
    reinforcement_locator_pad_radial_clearance = 0.30,
    reinforcement_locator_pad_axial_clearance = 0.10,
    reinforcement_locator_pin_radial_clearance = 0.20,
    reinforcement_locator_pin_length = 2.0,

    show_reference_pockets = true,
    reference_pocket_diameter = 3.0,
    reference_pocket_depth = 2.0,
    reference_pocket_min_back_wall = 0.7,
    reference_pocket_end_diameter = 2.0,
    reference_pocket_taper_depth = 0.5,
    reference_pocket_pitch = 10.0,
    reference_pocket_steps = [2, 3, 4],
    reference_pocket_lane_grid = 2.5,
    reference_pocket_lane_fraction = 0.25,
    reference_pocket_edge_margin = 4.0,

    show_center_reference_marks = true,
    center_mark_depth = 0.40,
    center_mark_pitch = 10.0,
    center_mark_major_length = 4.0,
    center_mark_minor_length = 2.2,
    center_mark_width = 0.8,
    center_mark_cross_length = 6.0,
    center_mark_edge_margin = 4.0,
    center_mark_screw_keepout = 3.0,

    seam_locator_height = 4,
    seam_locator_end_radius = 1.00
) =
    let(
        screw_x = _hub75_middle_coupler_seam_screw_x_positions(panel_obj)
    )
    assert(profile_size > 0, "profile_size must be > 0")
    assert(wall_thickness > 0, "wall_thickness must be > 0")
    assert(fit_clearance >= 0, "fit_clearance must be >= 0")
    assert(base_thickness > 0, "base_thickness must be > 0")
    assert(guide_height >= 0, "guide_height must be >= 0")
    assert(guide_end_rounding >= 0, "guide_end_rounding must be >= 0")
    assert(render_fn >= 24, "render_fn must be >= 24")
    assert(screw_hole_diameter > 0, "screw_hole_diameter must be > 0")
    assert(screw_relief_depth >= 0, "screw_relief_depth must be >= 0")
    assert(screw_relief_radial >= 0, "screw_relief_radial must be >= 0")
    assert(
        reinforcement_locator_pad_radial_clearance >= 0,
        "reinforcement locator pad radial clearance must be >= 0"
    )
    assert(
        reinforcement_locator_pad_axial_clearance >= 0,
        "reinforcement locator pad axial clearance must be >= 0"
    )
    assert(
        reinforcement_locator_pin_radial_clearance >= 0,
        "reinforcement locator pin radial clearance must be >= 0"
    )
    assert(
        reinforcement_locator_pin_length > 0,
        "reinforcement locator pin length must be > 0"
    )
    assert(reference_pocket_diameter > 0, "reference pocket diameter must be > 0")
    assert(reference_pocket_depth >= 0, "reference pocket depth must be >= 0")
    assert(
        reference_pocket_min_back_wall >= 0,
        "reference pocket minimum back wall must be >= 0"
    )
    assert(
        reference_pocket_end_diameter > 0
        && reference_pocket_end_diameter <= reference_pocket_diameter,
        "reference pocket end diameter must be > 0 and <= pocket diameter"
    )
    assert(
        reference_pocket_taper_depth >= 0
        && reference_pocket_taper_depth <= reference_pocket_depth,
        "reference pocket taper depth must be between 0 and pocket depth"
    )
    assert(reference_pocket_pitch > 0, "reference pocket pitch must be > 0")
    assert(reference_pocket_lane_grid > 0, "reference pocket lane grid must be > 0")
    assert(
        reference_pocket_lane_fraction > 0
        && reference_pocket_lane_fraction < 0.5,
        "reference pocket lane fraction must be between 0 and 0.5"
    )
    assert(reference_pocket_edge_margin >= 0, "reference pocket edge margin must be >= 0")
    assert(center_mark_depth >= 0, "center mark depth must be >= 0")
    assert(center_mark_pitch > 0, "center mark pitch must be > 0")
    assert(center_mark_major_length > 0, "center mark major length must be > 0")
    assert(center_mark_minor_length > 0, "center mark minor length must be > 0")
    assert(center_mark_width > 0, "center mark width must be > 0")
    assert(center_mark_cross_length > 0, "center mark cross length must be > 0")
    assert(center_mark_edge_margin >= 0, "center mark edge margin must be >= 0")
    assert(center_mark_screw_keepout >= 0, "center mark screw keepout must be >= 0")
    object(
        profile_size = profile_size,
        wall_thickness = wall_thickness,
        fit_clearance = fit_clearance,
        base_thickness = base_thickness,
        guide_height = guide_height,
        inside_corner_radius = inside_corner_radius,
        outside_corner_radius = outside_corner_radius,
        guide_end_rounding = guide_end_rounding,
        render_fn = render_fn,
        screw_hole_diameter = screw_hole_diameter,
        screw_relief_depth = screw_relief_depth,
        screw_relief_radial = screw_relief_radial,
        mounting_tube_radial_clearance = mounting_tube_radial_clearance,
        mounting_tube_axial_clearance = mounting_tube_axial_clearance,
        reinforcement_bushing_clearance = reinforcement_bushing_clearance,
        reinforcement_locator_pad_radial_clearance =
            reinforcement_locator_pad_radial_clearance,
        reinforcement_locator_pad_axial_clearance =
            reinforcement_locator_pad_axial_clearance,
        reinforcement_locator_pin_radial_clearance =
            reinforcement_locator_pin_radial_clearance,
        reinforcement_locator_pin_length =
            reinforcement_locator_pin_length,

        show_reference_pockets = show_reference_pockets,
        reference_pocket_diameter = reference_pocket_diameter,
        reference_pocket_depth = reference_pocket_depth,
        reference_pocket_min_back_wall = reference_pocket_min_back_wall,
        reference_pocket_end_diameter = reference_pocket_end_diameter,
        reference_pocket_taper_depth = reference_pocket_taper_depth,
        reference_pocket_pitch = reference_pocket_pitch,
        reference_pocket_steps = reference_pocket_steps,
        reference_pocket_lane_grid = reference_pocket_lane_grid,
        reference_pocket_lane_fraction = reference_pocket_lane_fraction,
        reference_pocket_edge_margin = reference_pocket_edge_margin,

        show_center_reference_marks = show_center_reference_marks,
        center_mark_depth = center_mark_depth,
        center_mark_pitch = center_mark_pitch,
        center_mark_major_length = center_mark_major_length,
        center_mark_minor_length = center_mark_minor_length,
        center_mark_width = center_mark_width,
        center_mark_cross_length = center_mark_cross_length,
        center_mark_edge_margin = center_mark_edge_margin,
        center_mark_screw_keepout = center_mark_screw_keepout,

        seam_locator_height = seam_locator_height,
        seam_locator_end_radius = seam_locator_end_radius,

        rear_seam_gap =
            hub75_p5_64x32_panel_rear_grid_gap_x(panel_obj),
        rear_side_rail_width =
            hub75_p5_64x32_panel_rear_side_rail_width_at_mounting_plane(panel_obj),
        rear_crossbar_width =
            hub75_p5_64x32_panel_rear_crossbar_width_at_mounting_plane(panel_obj),
        rear_opening_corner_radius =
            hub75_p5_64x32_panel_rear_opening_corner_radius(panel_obj),
        panel_taper_depth = hub75_rear_taper_depth(panel_obj),
        panel_rear_outer_inset_x =
            hub75_p5_64x32_panel_rear_outer_inset_x(panel_obj),

        mounting_tube_outer_diameter =
            hub75_p5_64x32_panel_mounting_tube_outer_diameter(panel_obj),
        mounting_tube_protrusion =
            hub75_p5_64x32_panel_mounting_tube_protrusion(panel_obj),

        reinforcement_bushing_outer_diameter =
            hub75_p5_64x32_panel_reinforcement_bushing_outer_diameter(panel_obj),
        reinforcement_bushing_recess_diameter =
            hub75_p5_64x32_panel_reinforcement_bushing_recess_diameter(panel_obj),
        reinforcement_bushing_recess_depth =
            hub75_p5_64x32_panel_reinforcement_bushing_recess_depth(panel_obj),
        reinforcement_bushing_hole_diameter =
            hub75_p5_64x32_panel_reinforcement_bushing_hole_diameter(panel_obj),
        reinforcement_bushing_hole_depth =
            hub75_p5_64x32_panel_reinforcement_bushing_hole_depth(panel_obj),
        reinforcement_bushing_offset =
            hub75_p5_64x32_panel_reinforcement_bushing_offset(panel_obj),

        screw_x_left = screw_x[0],
        screw_x_right = screw_x[1]
    );


// Function: hub75_middle_coupler_create_for_size()
// Description:
//   Creates one of the approved project size presets. Medium intentionally
//   matches the current default coupler geometry.
// Arguments:
//   size = "small", "medium" or "large".
//   panel_obj = HUB75 panel object that defines the mating geometry.
function hub75_middle_coupler_create_for_size(
    size = "medium",
    panel_obj = hub75_p5_64x32_panel_create(),
    render_fn = 192,
    show_reference_pockets = true,
    show_center_reference_marks = true
) =
    assert(
        size == "small" || size == "medium" || size == "large",
        str("Unsupported middle-coupler size: ", size)
    )
    size == "small"
        ? hub75_middle_coupler_create(
            panel_obj = panel_obj,
            profile_size = 60,
            wall_thickness = 2,
            guide_height = 4,
            base_thickness = 2,
            render_fn = render_fn,
            show_reference_pockets = show_reference_pockets,
            show_center_reference_marks = show_center_reference_marks
        )
        : size == "large"
            ? hub75_middle_coupler_create(
                panel_obj = panel_obj,
                profile_size = 100,
                wall_thickness = 6,
                guide_height = 10,
                base_thickness = 4,
                render_fn = render_fn,
                show_reference_pockets = show_reference_pockets,
                show_center_reference_marks = show_center_reference_marks
            )
            : hub75_middle_coupler_create(
                panel_obj = panel_obj,
                profile_size = 80,
                wall_thickness = 4,
                guide_height = 6,
                base_thickness = 3,
                render_fn = render_fn,
                show_reference_pockets = show_reference_pockets,
                show_center_reference_marks = show_center_reference_marks
            );


// Function: hub75_middle_coupler_horizontal_arm_height()
// Description: Returns the complete horizontal PLUS-arm height.
function hub75_middle_coupler_horizontal_arm_height(coupler_obj) =
    coupler_obj.rear_crossbar_width
    + 2 * (coupler_obj.wall_thickness + coupler_obj.fit_clearance);

// Function: hub75_middle_coupler_seam_keepout_width()
// Description:
//   Returns the physical rear-rib width occupied by two panel side rails plus
//   the nominal rear seam gap between them.
function hub75_middle_coupler_seam_keepout_width(coupler_obj) =
    2 * coupler_obj.rear_side_rail_width
    + coupler_obj.rear_seam_gap;

// Function: hub75_middle_coupler_vertical_arm_width()
// Description: Returns the complete vertical PLUS-arm width.
function hub75_middle_coupler_vertical_arm_width(coupler_obj) =
    hub75_middle_coupler_seam_keepout_width(coupler_obj)
    + 2 * (coupler_obj.wall_thickness + coupler_obj.fit_clearance);

// Function: hub75_middle_coupler_seam_locator_width()
// Description:
//   Returns the printable locator width inside the rear seam after equal
//   clearance is removed from both mating faces.
function hub75_middle_coupler_seam_locator_width(coupler_obj) =
    max(
        0,
        coupler_obj.rear_seam_gap
        - 2 * coupler_obj.fit_clearance
    );

// Function: hub75_middle_coupler_seam_locator_width_at_depth()
// Description:
//   Returns the available locator width at a requested insertion depth.
//   Both adjacent panel side walls move into the seam by the same panel-derived
//   taper displacement.
function hub75_middle_coupler_seam_locator_width_at_depth(
    coupler_obj,
    depth
) =
    max(
        0,
        hub75_middle_coupler_seam_locator_width(coupler_obj)
        - 2 * hub75_panel_taper_shift_at_depth_mm(
            depth,
            coupler_obj.panel_taper_depth,
            coupler_obj.panel_rear_outer_inset_x
        )
    );

// Function: hub75_middle_coupler_screw_x_positions()
// Description: Returns the two seam-side screw centres in local X coordinates.
function hub75_middle_coupler_screw_x_positions(coupler_obj) =
    [coupler_obj.screw_x_left, coupler_obj.screw_x_right];

// Function: hub75_middle_coupler_mounting_tube_pocket_diameter()
// Description: Returns the shallow base-pocket diameter around each panel tube.
function hub75_middle_coupler_mounting_tube_pocket_diameter(coupler_obj) =
    coupler_obj.mounting_tube_outer_diameter
    + 2 * coupler_obj.mounting_tube_radial_clearance;

// Function: hub75_middle_coupler_mounting_tube_pocket_depth()
// Description: Returns the panel-facing pocket depth into the base plate.
function hub75_middle_coupler_mounting_tube_pocket_depth(coupler_obj) =
    coupler_obj.mounting_tube_protrusion
    + coupler_obj.mounting_tube_axial_clearance;


// Function: hub75_middle_coupler_reinforcement_locator_pad_diameter()
// Description: Diameter of the large locator pad entering the Ø10 panel recess.
function hub75_middle_coupler_reinforcement_locator_pad_diameter(coupler_obj) =
    max(
        0.2,
        coupler_obj.reinforcement_bushing_recess_diameter
        - 2 * coupler_obj.reinforcement_locator_pad_radial_clearance
    );

// Function: hub75_middle_coupler_reinforcement_locator_pad_height()
// Description: Insertion depth of the large locator pad into the panel recess.
function hub75_middle_coupler_reinforcement_locator_pad_height(coupler_obj) =
    max(
        0.2,
        coupler_obj.reinforcement_bushing_recess_depth
        - coupler_obj.reinforcement_locator_pad_axial_clearance
    );

// Function: hub75_middle_coupler_reinforcement_locator_pin_diameter()
// Description: Diameter of the small pin entering the blind centre hole.
function hub75_middle_coupler_reinforcement_locator_pin_diameter(coupler_obj) =
    max(
        0.2,
        coupler_obj.reinforcement_bushing_hole_diameter
        - 2 * coupler_obj.reinforcement_locator_pin_radial_clearance
    );


// Function: hub75_middle_coupler_reference_pocket_effective_depth()
// Description:
//   Returns the actual blind-pocket depth after respecting both the requested
//   maximum depth and the minimum material that must remain behind the pocket.
function hub75_middle_coupler_reference_pocket_effective_depth(coupler_obj) =
    max(
        0,
        min(
            coupler_obj.reference_pocket_depth,
            coupler_obj.base_thickness
                - coupler_obj.reference_pocket_min_back_wall
        )
    );


// Function: hub75_middle_coupler_reference_pocket_straight_depth()
// Description:
//   Returns the cylindrical Ø3 section before the tapered pocket bottom.
function hub75_middle_coupler_reference_pocket_straight_depth(coupler_obj) =
    max(
        0,
        hub75_middle_coupler_reference_pocket_effective_depth(coupler_obj)
            - min(
                coupler_obj.reference_pocket_taper_depth,
                hub75_middle_coupler_reference_pocket_effective_depth(coupler_obj)
            )
    );


// Function: hub75_middle_coupler_reference_pocket_lane_offset()
// Description:
//   Returns the transverse pocket-lane offset for one PLUS arm. The target is
//   approximately one quarter of the arm thickness, snapped to a 2.5 mm grid.
function hub75_middle_coupler_reference_pocket_lane_offset(
    coupler_obj,
    arm_thickness
) =
    max(
        coupler_obj.reference_pocket_lane_grid,
        round(
            (
                arm_thickness
                * coupler_obj.reference_pocket_lane_fraction
            )
            / coupler_obj.reference_pocket_lane_grid
        )
        * coupler_obj.reference_pocket_lane_grid
    );

// Function: hub75_middle_coupler_reference_pocket_uses_two_lanes()
// Description:
//   Returns true only when two symmetric lanes fit in both PLUS arms with the
//   configured pocket diameter and edge margin.
function hub75_middle_coupler_reference_pocket_uses_two_lanes(coupler_obj) =
    _hub75_middle_coupler_reference_two_lanes_fit(
        coupler_obj,
        hub75_middle_coupler_horizontal_arm_height(coupler_obj)
    )
    &&
    _hub75_middle_coupler_reference_two_lanes_fit(
        coupler_obj,
        hub75_middle_coupler_vertical_arm_width(coupler_obj)
    );


// ----------------------------------------------------------------------
// Public geometry
// ----------------------------------------------------------------------

// Module: hub75_middle_coupler_build()
// Usage:
//   coupler = hub75_middle_coupler_create();
//   hub75_middle_coupler_build(coupler);
// Description:
//   Builds the complete middle coupler: functional fitted geometry plus the
//   blind reference pockets and shallow centre/distance reference marks on the
//   visible rear face.
module hub75_middle_coupler_build(coupler_obj) {
    // Do not rely on a top-level $fn assignment: this module is commonly
    // imported with use <...>, which does not import ordinary variable
    // assignments. Production geometry owns its resolution through the object.
    $fn = coupler_obj.render_fn;

    horizontal_arm =
        hub75_middle_coupler_horizontal_arm_height(coupler_obj);
    vertical_arm =
        hub75_middle_coupler_vertical_arm_width(coupler_obj);
    locator_width =
        hub75_middle_coupler_seam_locator_width_at_depth(
            coupler_obj,
            coupler_obj.seam_locator_height
        );
    pocket_depth =
        hub75_middle_coupler_mounting_tube_pocket_depth(coupler_obj);

    assert(
        horizontal_arm < coupler_obj.profile_size,
        "horizontal arm must fit inside profile_size"
    );
    assert(
        vertical_arm < coupler_obj.profile_size,
        "vertical arm must fit inside profile_size"
    );
    assert(
        locator_width > 0.5,
        "rear seam is too narrow for the configured locator clearance"
    );
    assert(
        pocket_depth < coupler_obj.base_thickness,
        "mounting-tube pocket must remain blind"
    );
    assert(
        coupler_obj.reinforcement_locator_pin_length
            <= coupler_obj.reinforcement_bushing_hole_depth,
        "reinforcement locator pin must fit inside the blind panel hole"
    );

    union() {
        _hub75_middle_coupler_base_with_surface_details(coupler_obj);

        if (coupler_obj.guide_height > 0)
            _hub75_middle_coupler_guide_walls(coupler_obj);

        _hub75_middle_coupler_reinforcement_locators(coupler_obj);

        if (coupler_obj.seam_locator_height > 0)
            _hub75_middle_coupler_seam_locator(coupler_obj);
    }
}


// Module: hub75_middle_coupler_render()
// Description:
//   Renders named design/debug construction stages without duplicating the
//   production geometry.
// Arguments:
//   coupler = Middle-coupler object.
//   view = final, functional, profile, base, screw-holes, tube-pockets,
//          guides, reinforcement-locators, seam-locator, reference-pockets or
//          center-marks.
module hub75_middle_coupler_render(coupler_obj, view = "final") {
    // Design/debug geometry must tessellate exactly like the production build.
    $fn = coupler_obj.render_fn;

    existing = [0.72, 0.72, 0.72, 1.0];
    existing_transparent = [0.72, 0.72, 0.72, 0.45];
    current = [0.88, 0.08, 0.06, 0.62];
    final_color = [0.72, 0.05, 0.04, 1.0];

    if (view == "functional") {
        color(existing)
            _hub75_middle_coupler_functional_build(coupler_obj);

    } else if (view == "profile") {
        color(current)
            _hub75_middle_coupler_extrude_xz_y(
                -0.35,
                 0.35
            )
                _hub75_middle_coupler_profile_2d(coupler_obj);

    } else if (view == "base") {
        color(current)
            _hub75_middle_coupler_base_solid(coupler_obj);

    } else if (view == "screw-holes") {
        color(existing_transparent)
            _hub75_middle_coupler_base_solid(coupler_obj);

        color(current)
            _hub75_middle_coupler_screw_cutters(coupler_obj);

    } else if (view == "tube-pockets") {
        color(existing)
            _hub75_middle_coupler_base_after_screw_holes(coupler_obj);

        color(current)
            _hub75_middle_coupler_mounting_tube_pocket_cutters(coupler_obj);

    } else if (view == "guides") {
        color(existing)
            _hub75_middle_coupler_base_after_pockets(coupler_obj);

        color(current)
            _hub75_middle_coupler_guide_walls(coupler_obj);

    } else if (view == "reinforcement-locators") {
        color(existing) {
            _hub75_middle_coupler_base_after_pockets(coupler_obj);
            _hub75_middle_coupler_guide_walls(coupler_obj);
        }

        color(current)
            _hub75_middle_coupler_reinforcement_locators(coupler_obj);

    } else if (view == "seam-locator") {
        color(existing) {
            _hub75_middle_coupler_base_after_pockets(coupler_obj);
            _hub75_middle_coupler_guide_walls(coupler_obj);
            _hub75_middle_coupler_reinforcement_locators(coupler_obj);
        }

        color(current)
            _hub75_middle_coupler_seam_locator(coupler_obj);

    } else if (view == "reference-pockets") {
        color(existing)
            _hub75_middle_coupler_functional_build(coupler_obj);

        color(current)
            _hub75_middle_coupler_reference_pocket_cutters(coupler_obj);

    } else if (view == "center-marks") {
        color(existing)
            _hub75_middle_coupler_functional_build(coupler_obj);

        color(current) {
            _hub75_middle_coupler_reference_pocket_cutters(coupler_obj);
            _hub75_middle_coupler_center_mark_cutters(coupler_obj);
        }

    } else {
        color(final_color)
            hub75_middle_coupler_build(coupler_obj);
    }
}


// ----------------------------------------------------------------------
// Private derived geometry
// ----------------------------------------------------------------------

function _hub75_middle_coupler_seam_screw_x_positions(panel_obj) =
    let(
        pitch =
            hub75_p5_64x32_panel_nominal_width(panel_obj),
        hole_x =
            hub75_p5_64x32_panel_hole_x_positions_centered(panel_obj)
    )
    [
        -pitch / 2 + hole_x[1],
         pitch / 2 + hole_x[0]
    ];


function _hub75_middle_coupler_reinforcement_positions(coupler_obj) =
    [
        [
            coupler_obj.screw_x_left,
            -coupler_obj.reinforcement_bushing_offset
        ],
        [
            coupler_obj.screw_x_right,
             coupler_obj.reinforcement_bushing_offset
        ]
    ];


// ----------------------------------------------------------------------
// Private PLUS profile
// ----------------------------------------------------------------------

module _hub75_middle_coupler_profile_2d(coupler_obj) {
    width = coupler_obj.profile_size;
    height = coupler_obj.profile_size;
    horizontal_arm_height =
        hub75_middle_coupler_horizontal_arm_height(coupler_obj);
    vertical_arm_width =
        hub75_middle_coupler_vertical_arm_width(coupler_obj);

    hw = width / 2;
    hh = height / 2;

    vx_left = -vertical_arm_width / 2;
    vx_right = vertical_arm_width / 2;
    z_top = horizontal_arm_height / 2;
    z_bottom = -horizontal_arm_height / 2;

    inside_r = min(
        coupler_obj.inside_corner_radius,
        min(
            hw - vx_right,
            hh - z_top
        ) - 0.01
    );

    outside_r = min(
        coupler_obj.outside_corner_radius,
        min(
            vertical_arm_width,
            horizontal_arm_height
        ) / 2 - 0.01
    );

    // Four times this count approximates a complete circle. This deliberately
    // uses the object's production resolution rather than ambient $fn, so the
    // result is identical when this file is imported through use <...>.
    steps = max(24, ceil(coupler_obj.render_fn / 4));

    points = concat(
        [[vx_left + outside_r, hh], [vx_right - outside_r, hh]],
        [for (a = [90 : -90 / steps : 0])
            [
                vx_right - outside_r + outside_r * cos(a),
                hh - outside_r + outside_r * sin(a)
            ]
        ],

        [[vx_right, z_top + inside_r]],
        [for (a = [180 : 90 / steps : 270])
            [
                vx_right + inside_r + inside_r * cos(a),
                z_top + inside_r + inside_r * sin(a)
            ]
        ],

        [[hw - outside_r, z_top]],
        [for (a = [90 : -90 / steps : 0])
            [
                hw - outside_r + outside_r * cos(a),
                z_top - outside_r + outside_r * sin(a)
            ]
        ],

        [[hw, z_bottom + outside_r]],
        [for (a = [0 : -90 / steps : -90])
            [
                hw - outside_r + outside_r * cos(a),
                z_bottom + outside_r + outside_r * sin(a)
            ]
        ],

        [[vx_right + inside_r, z_bottom]],
        [for (a = [90 : 90 / steps : 180])
            [
                vx_right + inside_r + inside_r * cos(a),
                z_bottom - inside_r + inside_r * sin(a)
            ]
        ],

        [[vx_right, -hh + outside_r]],
        [for (a = [0 : -90 / steps : -90])
            [
                vx_right - outside_r + outside_r * cos(a),
                -hh + outside_r + outside_r * sin(a)
            ]
        ],

        [[vx_left + outside_r, -hh]],
        [for (a = [-90 : -90 / steps : -180])
            [
                vx_left + outside_r + outside_r * cos(a),
                -hh + outside_r + outside_r * sin(a)
            ]
        ],

        [[vx_left, z_bottom - inside_r]],
        [for (a = [0 : 90 / steps : 90])
            [
                vx_left - inside_r + inside_r * cos(a),
                z_bottom - inside_r + inside_r * sin(a)
            ]
        ],

        [[-hw + outside_r, z_bottom]],
        [for (a = [-90 : -90 / steps : -180])
            [
                -hw + outside_r + outside_r * cos(a),
                z_bottom + outside_r + outside_r * sin(a)
            ]
        ],

        [[-hw, z_top - outside_r]],
        [for (a = [180 : -90 / steps : 90])
            [
                -hw + outside_r + outside_r * cos(a),
                z_top - outside_r + outside_r * sin(a)
            ]
        ],

        [[vx_left - inside_r, z_top]],
        [for (a = [-90 : 90 / steps : 0])
            [
                vx_left - inside_r + inside_r * cos(a),
                z_top + inside_r + inside_r * sin(a)
            ]
        ],

        [[vx_left, hh - outside_r]],
        [for (a = [180 : -90 / steps : 90])
            [
                vx_left + outside_r + outside_r * cos(a),
                hh - outside_r + outside_r * sin(a)
            ]
        ]
    );

    polygon(points = points);
}


// ----------------------------------------------------------------------
// Private base and cutters
// ----------------------------------------------------------------------

module _hub75_middle_coupler_extrude_xz_y(y_min, y_max) {
    assert(y_max > y_min, "Y extrusion span must be positive");

    fg_xf_frame(
        pos_mm = [0, y_max, 0],
        x_axis = [1, 0, 0],
        y_axis = [0, 0, 1]
    )
        linear_extrude(height = y_max - y_min)
            children();
}


module _hub75_middle_coupler_base_solid(coupler_obj) {
    _hub75_middle_coupler_extrude_xz_y(
        0,
        coupler_obj.base_thickness
    )
        _hub75_middle_coupler_profile_2d(coupler_obj);
}


module _hub75_middle_coupler_screw_cutters(coupler_obj) {
    relief_depth =
        min(
            coupler_obj.screw_relief_depth,
            coupler_obj.base_thickness / 2
                - _HUB75_MIDDLE_COUPLER_EPS
        );
    relief_diameter =
        coupler_obj.screw_hole_diameter
        + 2 * coupler_obj.screw_relief_radial;

    for (x = hub75_middle_coupler_screw_x_positions(coupler_obj)) {
        fg_xf_frame(
            pos_mm = [x, coupler_obj.base_thickness, 0],
            x_axis = [1, 0, 0],
            z_axis = [0, -1, 0]
        ) {
            fg_cut_cylinder(
                diameter_mm = coupler_obj.screw_hole_diameter,
                height_mm = coupler_obj.base_thickness,
                overlap = [FG_BOTTOM(), FG_TOP()],
                overlap_mm = _HUB75_MIDDLE_COUPLER_EPS
            );

            if (
                relief_depth > 0
                && coupler_obj.screw_relief_radial > 0
            )
                fg_cut_cylinder(
                    diameter_mm = relief_diameter,
                    height_mm = relief_depth,
                    overlap = [FG_BOTTOM()],
                    overlap_mm = _HUB75_MIDDLE_COUPLER_EPS
                );
        }

        if (
            relief_depth > 0
            && coupler_obj.screw_relief_radial > 0
        )
            fg_xf_frame(
                pos_mm = [x, relief_depth, 0],
                x_axis = [1, 0, 0],
                z_axis = [0, -1, 0]
            )
                fg_cut_cylinder(
                    diameter_mm = relief_diameter,
                    height_mm = relief_depth,
                    overlap = [FG_TOP()],
                    overlap_mm = _HUB75_MIDDLE_COUPLER_EPS
                );
    }
}


module _hub75_middle_coupler_mounting_tube_pocket_cutters(coupler_obj) {
    pocket_depth =
        hub75_middle_coupler_mounting_tube_pocket_depth(coupler_obj);
    pocket_diameter =
        hub75_middle_coupler_mounting_tube_pocket_diameter(coupler_obj);

    for (x = hub75_middle_coupler_screw_x_positions(coupler_obj))
        fg_xf_frame(
            pos_mm = [x, 0, 0],
            x_axis = [1, 0, 0],
            z_axis = [0, 1, 0]
        )
            fg_cut_cylinder(
                diameter_mm = pocket_diameter,
                height_mm = pocket_depth,
                overlap = [FG_BOTTOM()],
                overlap_mm = _HUB75_MIDDLE_COUPLER_EPS
            );
}


module _hub75_middle_coupler_base_after_screw_holes(coupler_obj) {
    fg_diff() {
        fg_body()
            _hub75_middle_coupler_base_solid(coupler_obj);

        fg_remove()
            _hub75_middle_coupler_screw_cutters(coupler_obj);
    }
}


module _hub75_middle_coupler_base_after_pockets(coupler_obj) {
    fg_diff() {
        fg_body()
            _hub75_middle_coupler_base_after_screw_holes(coupler_obj);

        fg_remove()
            _hub75_middle_coupler_mounting_tube_pocket_cutters(coupler_obj);
    }
}


// ----------------------------------------------------------------------
// Private surface reference geometry
// ----------------------------------------------------------------------

function _hub75_middle_coupler_reference_two_lanes_fit(
    coupler_obj,
    arm_thickness
) =
    let(
        lane_offset =
            hub75_middle_coupler_reference_pocket_lane_offset(
                coupler_obj,
                arm_thickness
            ),
        remaining =
            arm_thickness / 2
            - lane_offset
            - coupler_obj.reference_pocket_diameter / 2
    )
    remaining >= coupler_obj.reference_pocket_edge_margin;


module _hub75_middle_coupler_reference_pocket_strip_2d(
    coupler_obj,
    axis = "x",
    direction_sign = 1,
    lane_signs = [-1, 1],
    lane_offset = 7.5
) {
    for (step = coupler_obj.reference_pocket_steps)
        for (lane = lane_signs)
            if (axis == "x")
                fg_xf_xzmove([
                    direction_sign
                        * step
                        * coupler_obj.reference_pocket_pitch,
                    lane * lane_offset
                ])
                    circle(
                        d = coupler_obj.reference_pocket_diameter
                    );
            else
                fg_xf_xzmove([
                    lane * lane_offset,
                    direction_sign
                        * step
                        * coupler_obj.reference_pocket_pitch
                ])
                    circle(
                        d = coupler_obj.reference_pocket_diameter
                    );
}


function _hub75_middle_coupler_reference_pocket_positions(coupler_obj) =
    let(
        horizontal_arm =
            hub75_middle_coupler_horizontal_arm_height(coupler_obj),
        vertical_arm =
            hub75_middle_coupler_vertical_arm_width(coupler_obj),
        x_lane =
            hub75_middle_coupler_reference_pocket_lane_offset(
                coupler_obj,
                horizontal_arm
            ),
        z_lane =
            hub75_middle_coupler_reference_pocket_lane_offset(
                coupler_obj,
                vertical_arm
            ),
        lane_signs =
            hub75_middle_coupler_reference_pocket_uses_two_lanes(coupler_obj)
                ? [-1, 1]
                : [0]
    )
    concat(
        [
            for (
                direction = [-1, 1],
                step = coupler_obj.reference_pocket_steps,
                lane = lane_signs
            )
                [
                    direction * step * coupler_obj.reference_pocket_pitch,
                    lane * x_lane
                ]
        ],
        [
            for (
                direction = [-1, 1],
                step = coupler_obj.reference_pocket_steps,
                lane = lane_signs
            )
                [
                    lane * z_lane,
                    direction * step * coupler_obj.reference_pocket_pitch
                ]
        ]
    );


module _hub75_middle_coupler_reference_pockets_2d(coupler_obj) {
    for (position_xz_mm =
        _hub75_middle_coupler_reference_pocket_positions(coupler_obj)
    )
        fg_xf_xzmove([position_xz_mm[0], position_xz_mm[1]])
            circle(d = coupler_obj.reference_pocket_diameter);
}


module _hub75_middle_coupler_reference_pocket_pattern_2d(coupler_obj) {
    intersection() {
        // A true geometric edge keep-out: pocket centres must remain inside
        // an inset of the actual rounded PLUS outline.
        offset(delta = -coupler_obj.reference_pocket_edge_margin)
            _hub75_middle_coupler_profile_2d(coupler_obj);

        _hub75_middle_coupler_reference_pockets_2d(coupler_obj);
    }
}


module _hub75_middle_coupler_center_marks_2d(coupler_obj) {
    difference() {
        union() {
            // The local X/Z origin is the nominal panel seam / middle row.
            square(
                [
                    coupler_obj.center_mark_cross_length,
                    coupler_obj.center_mark_width
                ],
                center = true
            );
            square(
                [
                    coupler_obj.center_mark_width,
                    coupler_obj.center_mark_cross_length
                ],
                center = true
            );

            // Ticks every 5 mm. Full centimetres are the longer marks.
            for (
                x = [
                    coupler_obj.center_mark_pitch / 2
                    :
                    coupler_obj.center_mark_pitch / 2
                    :
                    coupler_obj.profile_size / 2
                ]
            ) {
                major =
                    abs(
                        (x / coupler_obj.center_mark_pitch)
                        - round(x / coupler_obj.center_mark_pitch)
                    ) < 0.001;
                tick_length =
                    major
                        ? coupler_obj.center_mark_major_length
                        : coupler_obj.center_mark_minor_length;

                fg_xf_xzmove([x, 0])
                    square(
                        [
                            coupler_obj.center_mark_width,
                            tick_length
                        ],
                        center = true
                    );
                fg_xf_xzmove([-x, 0])
                    square(
                        [
                            coupler_obj.center_mark_width,
                            tick_length
                        ],
                        center = true
                    );
            }

            for (
                z = [
                    coupler_obj.center_mark_pitch / 2
                    :
                    coupler_obj.center_mark_pitch / 2
                    :
                    coupler_obj.profile_size / 2
                ]
            ) {
                major =
                    abs(
                        (z / coupler_obj.center_mark_pitch)
                        - round(z / coupler_obj.center_mark_pitch)
                    ) < 0.001;
                tick_length =
                    major
                        ? coupler_obj.center_mark_major_length
                        : coupler_obj.center_mark_minor_length;

                fg_xf_xzmove([0, z])
                    square(
                        [
                            tick_length,
                            coupler_obj.center_mark_width
                        ],
                        center = true
                    );
                fg_xf_xzmove([0, -z])
                    square(
                        [
                            tick_length,
                            coupler_obj.center_mark_width
                        ],
                        center = true
                    );
            }
        }

        // Keep all reference engraving away from the structural screw lands.
        screw_keepout_radius =
            coupler_obj.screw_hole_diameter / 2
            + coupler_obj.center_mark_screw_keepout;

        for (x = hub75_middle_coupler_screw_x_positions(coupler_obj))
            fg_xf_xzmove([x, 0])
                circle(r = screw_keepout_radius);
    }
}


module _hub75_middle_coupler_center_mark_pattern_2d(coupler_obj) {
    intersection() {
        offset(delta = -coupler_obj.center_mark_edge_margin)
            _hub75_middle_coupler_profile_2d(coupler_obj);

        _hub75_middle_coupler_center_marks_2d(coupler_obj);
    }
}


module _hub75_middle_coupler_reference_pocket_cutters(coupler_obj) {
    depth =
        hub75_middle_coupler_reference_pocket_effective_depth(coupler_obj);
    taper_depth =
        min(
            coupler_obj.reference_pocket_taper_depth,
            depth
        );
    straight_depth =
        max(0, depth - taper_depth);

    if (
        coupler_obj.show_reference_pockets
        && depth > 0
    )
        intersection() {
            // Keep every cutter inside the same true rounded PLUS inset used
            // by the old 2D pocket pattern.
            _hub75_middle_coupler_extrude_xz_y(
                coupler_obj.base_thickness - depth
                    - _HUB75_MIDDLE_COUPLER_EPS,
                coupler_obj.base_thickness
                    + _HUB75_MIDDLE_COUPLER_EPS
            )
                offset(delta = -coupler_obj.reference_pocket_edge_margin)
                    _hub75_middle_coupler_profile_2d(coupler_obj);

            union()
                for (position_xz_mm =
                    _hub75_middle_coupler_reference_pocket_positions(coupler_obj)
                ) {
                    // Visible section stays cylindrical at Ø3 mm.
                    if (straight_depth > 0)
                        fg_xf_frame(
                            pos_mm = [
                                position_xz_mm[0],
                                coupler_obj.base_thickness
                                    + _HUB75_MIDDLE_COUPLER_EPS,
                                position_xz_mm[1]
                            ],
                            x_axis = [1, 0, 0],
                            z_axis = [0, -1, 0]
                        )
                            cylinder(
                                h =
                                    straight_depth
                                    + _HUB75_MIDDLE_COUPLER_EPS,
                                d = coupler_obj.reference_pocket_diameter
                            );

                    // Only the final section narrows, default Ø3 -> Ø2
                    // over 0.5 mm. Thin presets clamp the total blind depth
                    // so the configured minimum back wall always remains.
                    if (taper_depth > 0)
                        fg_xf_frame(
                            pos_mm = [
                                position_xz_mm[0],
                                coupler_obj.base_thickness
                                    - straight_depth
                                    + _HUB75_MIDDLE_COUPLER_EPS,
                                position_xz_mm[1]
                            ],
                            x_axis = [1, 0, 0],
                            z_axis = [0, -1, 0]
                        )
                            cylinder(
                                h =
                                    taper_depth
                                    + 2 * _HUB75_MIDDLE_COUPLER_EPS,
                                d1 = coupler_obj.reference_pocket_diameter,
                                d2 = coupler_obj.reference_pocket_end_diameter
                            );
                }
        }
}


module _hub75_middle_coupler_center_mark_cutters(coupler_obj) {
    depth =
        min(
            coupler_obj.center_mark_depth,
            coupler_obj.base_thickness - 0.2
        );
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
