brainboxemb/2026-009-01.cad.HUB75-display-frame/(list of files, cad)

Other CAD files:
vrf/openscad/corner-edge-coupler-left-xy-side-edge-section.scad
vrf/openscad/corner-edge-coupler-left-yz-top-edge-section.scad
vrf/openscad/corner-edge-coupler-right-fit-detail.scad
vrf/openscad/corner-edge-coupler-right-rear-fit-section.scad
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
