brainboxemb/2026-009-01.cad.HUB75-display-frame/doc/20-00-manuals.md

# HUB75 display-frame manuals

Practical guidance is split by audience:

- [20-01 — Development](20-01-development.md) — contributors and maintainers;
- [20-02 — User](20-02-user.md) — users inspecting/building the current project state.

Component-specific construction and physical procedures stay beside the owning
source/evidence rather than being duplicated here.
