brainboxemb/2026-009-01.cad.HUB75-display-frame/(commit log)

2026-09-09 Bootstrap five-panel HUB75 assembly
    [main.scad, panels-assembly.scad, panels_assembly.scad]
2026-09-09 Verify five-panel nominal display size
    [panels-assembly.scad]
2026-09-09 Add standard project links, full views and STL verification
    [front-angled.scad, front.scad, panels-assembly.scad, panels_assembly.scad, rear-angled.scad, rear.scad]
2026-09-09 Temporarily dispatch current v0.6.1 build
2026-09-09 Align project origin with classic HUB75 model
    [panels_assembly.scad]
2026-09-09 Center display origin through panel depth
    [panels_assembly.scad]
2026-09-09 Use HUB75 front face as project Y datum
    [panels_assembly.scad]
2026-09-09 Apply private OpenSCAD naming convention
    [panels_assembly.scad]
2026-09-09 Introduce object-based middle coupler core
    [hub75_middle_coupler.scad, hub75_middle_coupler_render.scad, main.scad, middle-coupler-fit-section.scad, middle-coupler-fit.scad, middle-coupler.scad, middle_coupler_fit_assembly.scad]
2026-09-09 Fix middle coupler structured docs
    [hub75_middle_coupler.scad]
2026-09-09 Document middle coupler milestone
2026-09-09 Restore rounded v120 middle coupler form
    [hub75_middle_coupler.scad, middle-coupler.scad]
2026-09-09 Make current project the design authority
2026-09-09 Enforce middle coupler STL tessellation
    [hub75_middle_coupler.scad, middle-coupler.scad]
2026-09-09 Add middle coupler reinforcement locators
    [hub75_middle_coupler.scad, middle-coupler.scad]
2026-09-09 Move middle coupler fit evidence to verification
    [middle-coupler-fit-detail.scad, middle-coupler-fit-section.scad, middle-coupler-fit.scad, middle-coupler-rear-fit-section.scad, middle-coupler-xy-seam-section.scad, middle_coupler_fit_assembly.scad]
2026-09-09 Add middle coupler surface reference details
    [hub75_middle_coupler.scad, middle-coupler.scad]
2026-09-09 Use light gray panels in display renders
    [panels_assembly.scad]
2026-09-09 Show coupler surface details from rear
    [panels_assembly.scad]
2026-09-09 Add multi-size coupler builds and verification
    * Add middle coupler size presets
    * Render middle coupler by size preset
    * Export middle coupler by size preset
    * Make STL regression checks size-aware
    * Make middle coupler verification size-aware
    * Make middle coupler verification size-aware
    * Make middle coupler verification size-aware
    * Configure multi-size coupler renders
    * Configure multi-size coupler exports
    * Verify all middle coupler sizes
    * Document multi-size verification evidence
    * Use directory-based build discovery
    * Use tool.scad-project v0.7.0
    * Use tool.scad-project v0.7.0
    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
    [hub75_middle_coupler.scad, middle-coupler-fit-detail.scad, middle-coupler-rear-fit-section.scad, middle-coupler-xy-seam-section.scad, middle-coupler.scad]
2026-09-09 Fix small guide wall and verification layout
    * Preserve thin guide walls in small coupler
    * Flatten verification outputs and fit all render sizes
    * Add flat verification PNG gallery
    * Link flat verification gallery
    * Document guide and verification fixes
    * Scale coupler camera distance by size
    * Use SCAD camera framing for verification renders
    * Give all coupler sizes safe render framing
    [hub75_middle_coupler.scad, middle-coupler.scad]
2026-09-09 Add print-friendly pocket tapers and screw relief
    * Taper reference pockets and restore screw relief
    * Verify tapered pockets and screw relief
    * Document print-friendly pocket and screw details
    * Record print-friendly pocket and screw details
    [hub75_middle_coupler.scad, middle-coupler.scad]
2026-09-09 Make reference pockets shallower
    * Make reference pocket depth thickness-aware
    * Expose effective reference pocket depths
    * Verify shallower reference pocket depths
    * Document thickness-aware pocket depth
    * Record shallower thickness-aware reference pockets
    [hub75_middle_coupler.scad, middle-coupler.scad]
2026-09-09 Add horizontal edge coupler core
    * Use locator-pin mating API
    * Pin merged locator-pin mating API
    * Add horizontal edge coupler core
    * Add horizontal edge coupler entrypoints
    * Add horizontal edge coupler entrypoints
    * Add horizontal edge coupler entrypoints
    * Add horizontal edge coupler entrypoints
    * Build horizontal edge coupler in all sizes
    * Build horizontal edge coupler in all sizes
    * Keep nominal edge reference marks visible
    * Complete horizontal edge design camera
    * Add horizontal edge fit verification
    * Add horizontal edge fit verification
    * Add horizontal edge fit verification
    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
    [horizontal-edge-coupler-fit-detail.scad, horizontal-edge-coupler-rear-fit-section.scad, horizontal-edge-coupler-yz-edge-section.scad, horizontal-edge-coupler.scad, horizontal_edge_coupler_fit_assembly.scad, hub75_horizontal_edge_coupler.scad, hub75_horizontal_edge_coupler_render.scad, middle-coupler-rear-fit-section.scad]
2026-09-09 Add left and right corner edge couplers
    * Add corner edge coupler core
    * Add corner edge coupler build entrypoints
    * Add corner edge coupler build entrypoints
    * Add corner edge coupler build entrypoints
    * Add corner edge coupler build entrypoints
    * Build corner edge couplers in all sizes
    * Build corner edge couplers in all sizes
    * Document corner edge coupler design
    * Document corner edge coupler design
    * Keep corner outer ridge structurally simple
    * Add corner edge fit verification
    * Add corner edge fit verification
    * Add corner edge fit verification
    * Add corner edge fit verification
    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
    [corner-edge-coupler-left-fit-detail.scad, corner-edge-coupler-left-rear-fit-section.scad, corner-edge-coupler-left.scad, corner-edge-coupler-right-fit-detail.scad, corner-edge-coupler-right-rear-fit-section.scad, corner-edge-coupler-right.scad, corner_edge_coupler_fit_assembly.scad, horizontal_edge_coupler_fit_assembly.scad]
2026-09-10 Adopt tool.scad-project v0.9.0 release lifecycle
    Pin HUB75 to tool.scad-project v0.9.0, move production publication to prod/*, add the coordinated project release caller, and avoid duplicate Build/Verify runs for release requests and tags.
2026-09-10 Align HUB75 documentation with v0.9.0 lifecycle
    Update README and ChatGPT handoff to the current prod/* publication model, v0.9.0 tooling baseline, completed connector-family state and validated unchanged-build cache behaviour.
2026-09-10 Add rear coupler overview and build PNG gallery
    Add a complete rear-angled five-panel overview with the current connector family, adopt tool.scad-project v0.9.1, and expose the generated normal-build PNG gallery.
    [display_frame_assembly.scad, rear-angled-couplers.scad]
2026-09-10 Share HUB75 panel taper mating rule
    [hub75_panel_mating.scad]
2026-09-10 Derive horizontal edge mating from panel taper
    [hub75_horizontal_edge_coupler.scad]
2026-09-10 Derive middle seam locator from panel taper
    [hub75_middle_coupler.scad]
2026-09-10 Document panel-derived coupler taper
2026-09-10 Upgrade tool.scad-project to v0.9.5
    Pin project tooling and reusable Build/Verify/Release workflows to the cache-summary runtime fix release.
2026-09-10 Upgrade to tool v0.9.8 and prepare first v0.0.1 release
    * Pin semantic tool dependency to v0.9.8
    * Pin Build workflow to tool v0.9.8 commit
    * Pin Verify workflow to tool v0.9.8 commit
    * Pin Release workflow to tool v0.9.8 commit
    * Sync Bash updater with tool v0.9.8
    * Sync PowerShell updater with tool v0.9.8
    * Update tool.scad-project gitlink to v0.9.8
    * Prepare HUB75 v0.0.1 changelog
    * Update HUB75 tooling and release documentation
    * Preserve HUB75 render configuration during tool upgrade
2026-09-11 chore: pin lib.scad.hub75 v0.1.0
2026-09-11 refactor: organize verification assemblies
    [corner-edge-coupler-left-fit-detail.scad, corner-edge-coupler-left-rear-fit-section.scad, corner-edge-coupler-right-fit-detail.scad, corner-edge-coupler-right-rear-fit-section.scad, corner_edge_coupler_fit_assembly.scad, horizontal-edge-coupler-fit-detail.scad, horizontal-edge-coupler-rear-fit-section.scad, horizontal-edge-coupler-yz-edge-section.scad]
2026-09-11 docs: expand middle coupler construction views
    [hub75_middle_coupler_render.scad]
2026-09-11 docs: explain middle coupler construction in depth
2026-09-11 docs: align middle coupler profile views
    [hub75_middle_coupler_render.scad]
2026-09-11 docs: improve middle coupler construction views
    [hub75_middle_coupler_render.scad]
2026-09-11 docs: clarify middle coupler guide keepout view
    [hub75_middle_coupler_render.scad]
2026-09-11 docs: show panel context for reinforcement guide reliefs
    [hub75_middle_coupler_render.scad]
2026-09-11 docs: focus reinforcement relief view on one panel detail
    [hub75_middle_coupler_render.scad]
2026-09-11 docs: emphasize reinforcement clearance in guide detail
    [hub75_middle_coupler_render.scad]
2026-09-11 docs: separate reinforcement overview and detail
    [hub75_middle_coupler_render.scad]
2026-09-11 chore: pin tool.scad-project v0.9.9
2026-09-11 chore: pin build workflow to tool v0.9.9
2026-09-11 chore: pin verify workflow to tool v0.9.9
2026-09-11 chore: pin release workflow to tool v0.9.9
2026-09-11 docs: complete middle coupler implementation narrative
2026-09-11 docs: rebuild edge coupler design narratives
    [hub75_corner_edge_coupler_render.scad, hub75_horizontal_edge_coupler_render.scad]
2026-09-11 fix: keep edge design adapters use-safe
    [hub75_corner_edge_coupler_render.scad, hub75_horizontal_edge_coupler_render.scad]
2026-09-11 fix: import panel taper helper in design adapter
    [hub75_horizontal_edge_coupler_render.scad]
2026-09-11 docs: tune edge coupler design views
    [hub75_corner_edge_coupler_render.scad, hub75_horizontal_edge_coupler_render.scad]
2026-09-11 docs: refine edge design detail framing
    [hub75_corner_edge_coupler_render.scad, hub75_horizontal_edge_coupler_render.scad]
2026-09-11 build: update lib.scad.hub75 to v0.1.1
    Pin the HUB75 panel library to immutable v0.1.1, including the rear bay-end relief fix validated against the frame fit checks.
2026-09-11 build: update lib.scad.hub75 to v0.1.2
    Pin the frame project to immutable lib.scad.hub75 v0.1.2 so the rear horizontal orientation markers use the validated 12 mm visual inset. No frame or coupler geometry changes are included.
2026-09-11 chore: adopt PR-scoped publication workflow
    Upgrade the HUB75 display-frame project to tool.scad-project v0.9.11, isolate generated previews per pull request, use PR-first Build/Verify triggers, and clean preview/source branches after merge.
2026-09-11 feat: restore interactive OpenSCAD entrypoint
    Restore main.scad as the human-facing OpenSCAD controller with Customizer views, preset/custom coupler profiles, visibility controls and exploded inspection. Extend the current object-based display assembly without duplicating production geometry, add two useful build overview renders, and smoke-test the interactive entrypoint in verification.
    [display_frame_assembly.scad, main.scad, rear-angled-couplers-only.scad, rear-angled-exploded.scad]
2026-09-11 fix: straighten horizontal-edge guide outer wall
    Keep the exposed outer guide wall straight while the panel-facing edge follows the real HUB75 taper, use a 0.10 mm rear-fit section, and watermark verification PNGs consistently.
    [horizontal-edge-coupler-rear-fit-section.scad, horizontal_edge_coupler_fit_assembly.scad, hub75_horizontal_edge_coupler.scad, hub75_horizontal_edge_coupler_render.scad]
2026-09-11 Preserve material around horizontal-edge reinforcement rings (#25)
    Preserve the configured wall thickness around horizontal-edge reinforcement clearances by extending the structural profile only where required. Keep wider presets visually unchanged where their existing profile already contains the support envelope, and document the construction rule.
    [hub75_horizontal_edge_coupler.scad, hub75_horizontal_edge_coupler_render.scad]
2026-09-11 chore: stage PR26 corner refinement
2026-09-11 chore: stage PR26 corner patch script
2026-09-11 feat: refine corner taper and fit verification
    [corner-edge-coupler-left-xy-side-edge-section.scad, corner-edge-coupler-left-yz-top-edge-section.scad, corner-edge-coupler-right-xy-side-edge-section.scad, corner-edge-coupler-right-yz-top-edge-section.scad, corner_edge_coupler_fit_assembly.scad, hub75_corner_edge_coupler.scad, hub75_corner_edge_coupler_render.scad]
2026-09-11 chore: stage PR26 taper-helper import fix
2026-09-11 fix: import corner taper helper
    [hub75_corner_edge_coupler.scad]
2026-09-11 fix: expose complete corner fit and taper evidence
    [corner-edge-coupler-left-rear-fit-section.scad, corner-edge-coupler-right-rear-fit-section.scad, corner_edge_coupler_fit_assembly.scad, hub75_corner_edge_coupler_render.scad]
2026-09-11 fix: preserve concave corner contours while clipping panel taper
    [hub75_corner_edge_coupler.scad]
2026-09-11 vrf: add readable corner profile sections
    [corner_edge_coupler_profile_sections.scad]
2026-09-11 vrf: add canonical horizontal corner profile
    [corner-edge-coupler-horizontal-profile-section.scad]
2026-09-11 vrf: add canonical vertical corner profile
    [corner-edge-coupler-vertical-profile-section.scad]
2026-09-11 vrf: add horizontal-edge seam profile section
    [horizontal_edge_coupler_fit_assembly.scad]
2026-09-11 vrf: render horizontal-edge seam profile section
    [horizontal-edge-coupler-xy-seam-section.scad]
2026-09-11 test: probe selective corner verification cache
    [corner-edge-coupler-horizontal-profile-section.scad, corner-edge-coupler-left-fit-detail.scad, corner-edge-coupler-left-rear-fit-section.scad, corner-edge-coupler-left-xy-side-edge-section.scad, corner-edge-coupler-left-yz-top-edge-section.scad, corner-edge-coupler-right-fit-detail.scad, corner-edge-coupler-right-rear-fit-section.scad, corner-edge-coupler-right-xy-side-edge-section.scad]
2026-09-11 test: remove selective verification cache probe
    [corner-edge-coupler-horizontal-profile-section.scad, corner-edge-coupler-left-fit-detail.scad, corner-edge-coupler-left-rear-fit-section.scad, corner-edge-coupler-left-xy-side-edge-section.scad, corner-edge-coupler-left-yz-top-edge-section.scad, corner-edge-coupler-right-fit-detail.scad, corner-edge-coupler-right-rear-fit-section.scad, corner-edge-coupler-right-xy-side-edge-section.scad]
2026-09-13 Delegate PowerShell bootstrap to tool.git-project
2026-09-13 Delegate PowerShell repository update through SCAD bridge
2026-09-13 Pin generic bootstrap and migrated SCAD tool gitlinks
2026-09-13 Verify separated bootstrap ownership before CAD evidence
2026-09-14 ci: pin PR cleanup to tool.scad-project v0.11.0
2026-09-14 ci: pin release workflow to tool.scad-project v0.11.0
2026-09-14 build: pin tool.scad-project v0.11.0
2026-09-14 Probe T6 input-equivalent hydration
2026-09-14 Remove T6 hydration probe
2026-09-14 Probe selective middle coupler rebuild
    [middle-coupler.scad]
2026-09-14 Remove selective rebuild probe
    [middle-coupler.scad]
2026-09-14 Pin release workflow to tool.scad-project v0.12.0
2026-09-14 Pin released SCAD tool and HUB75 library commits
2026-09-14 Document current SCAD dependency baseline
2026-09-16 Migration 005 — adopt shared SCAD capability lifecycle (#33)
    Adopt the released Migration-005 shared SCAD capability lifecycle, focused OpenSCAD v0.5.0 runtime, SCons materialization, immutable HUB75 v0.1.5 dependency, and current tooling documentation.
2026-09-16 Align final Migration 005 baseline to tool.scad-project v0.14.8
    Use semantic v0.14.8 Production/Release callers and exact tool gitlink 85781a6b without changing CAD geometry.
2026-09-16 Prepare HUB75 frame v0.0.2 release
    Promote the accumulated changelog to v0.0.2 and align README tooling documentation with the final Migration 005 v0.14.8 baseline.
2026-09-16 Migration 005: qualify v0.14.9 bld/vrf namespaces
    Align the display-frame project with tool.scad-project v0.14.9 and canonical bld/vrf publication namespaces while preserving the existing lib.scad.hub75 geometry dependency.
2026-09-16 Prepare HUB75 frame v0.0.3 release
    Record Migration-005 v0.14.9 namespace-normalization release evidence without changing project geometry or dependencies.
2026-09-18 docs: add detachable clip design track
2026-09-18 fix: alternate HUB75 panel orientation
    [panels_assembly.scad]
2026-09-18 verify: use alternating panels for middle fit
    [middle_coupler_fit_assembly.scad]
2026-09-18 verify: use alternating panels for edge fit
    [horizontal_edge_coupler_fit_assembly.scad]
2026-09-18 docs: clarify seam orientation evidence
    [middle_coupler_fit_assembly.scad]
2026-09-18 docs: explain connector-heavy seam fixture
    [horizontal_edge_coupler_fit_assembly.scad]
2026-09-18 docs: record core coupler digital acceptance
2026-09-18 verification: prepare physical coupler fit cases
2026-09-20 chore: add clamp and utility dependencies
2026-09-20 chore: register clamp and utility gitlinks
2026-09-20 feat: add detachable reinforcement components
    [aluminium_tube.scad]
2026-09-20 feat: integrate sliding dovetail reinforcement layer
    [display_frame_assembly.scad, dovetail_tube_clamp.scad, main.scad, reinforced_couplers.scad]
2026-09-20 refactor: use shared section inspection utility
    [corner_edge_coupler_fit_assembly.scad, corner_edge_coupler_profile_sections.scad, horizontal_edge_coupler_fit_assembly.scad, middle_coupler_fit_assembly.scad]
2026-09-20 feat: publish reinforced couplers and dovetail clip evidence
    [dovetail-tube-clamp-fit.scad, dovetail-tube-clamp-yz-section.scad, dovetail-tube-clamp.scad, dovetail_tube_clip_fit_assembly.scad, reinforced-corner-edge-coupler-left.scad, reinforced-corner-edge-coupler-right.scad, reinforced-horizontal-edge-coupler.scad]
2026-09-20 fix: orient clamp foot as dovetail and separate exploded layers
    [aluminium_tube.scad, display_frame_assembly.scad, dovetail-tube-clamp.scad, dovetail_tube_clamp.scad, dovetail_tube_clip_fit_assembly.scad, main.scad, reinforced-display-assembly.scad, reinforced_couplers.scad]
2026-09-20 fix: make lower clamp foot the dovetail
    [dovetail_tube_clamp.scad]
2026-09-20 fix: use local side-entry dovetail mounting points
    [dovetail_tube_clamp.scad, reinforced-display-2-panel.scad, reinforced_couplers.scad]
2026-09-20 docs: gate reinforcement print-fit behind core acceptance
2026-09-20 fix: allow focused multi-panel inspection assemblies
    [panels_assembly.scad]
2026-09-20 fix: align dovetail foot with clamp body
    [dovetail_tube_clamp.scad, reinforced_couplers.scad]
2026-09-20 refactor: name tube mounts and use one clamp type
    [corner-edge-tube-mount-coupler-left.scad, corner-edge-tube-mount-coupler-right.scad, display_frame_assembly.scad, dovetail-tube-clamp-fit.scad, dovetail-tube-clamp.scad, dovetail_tube_clamp.scad, dovetail_tube_clamp_fit_assembly.scad, horizontal-edge-tube-mount-clamp-fit.scad]
2026-09-20 refactor: define shared dovetail interface
    [dovetail_interface.scad, dovetail_tube_clamp.scad, tube_mount_couplers.scad]
2026-09-20 fix: preserve exact dovetail interface depth
    [dovetail_tube_clamp.scad]
2026-09-20 Use lib.scad.mechint for locked tube mounts
    [display_frame_assembly.scad, dovetail_interface.scad, dovetail_tube_clamp.scad, dovetail_tube_clamp_fit_assembly.scad, horizontal-edge-tube-mount-lock-section.scad, tube_mount_couplers.scad]
2026-09-20 Thin HUB75 tube-mount interface
    [dovetail_interface.scad, dovetail_tube_clamp.scad, tube_mount_couplers.scad]
2026-09-20 Preserve historical tube position
    [dovetail_tube_clamp.scad]
2026-09-20 Add two-panel tube-mount assembly
    [tube-mount-display-2-panel.scad, tube_mount_display_2_panel_assembly.scad]
2026-09-20 Expose two-panel assembly in main view
    [main.scad]
2026-09-20 Document two-panel debug frame
    [tube_mount_display_2_panel_assembly.scad]
2026-09-20 Flatten and widen tube-mount dovetail
    [dovetail_interface.scad, dovetail_tube_clamp.scad, tube_mount_couplers.scad]
2026-09-20 Add low-detail interactive preview
    [display_frame_assembly.scad, hub75_corner_edge_coupler.scad, hub75_horizontal_edge_coupler.scad, hub75_middle_coupler.scad, main.scad, panels_assembly.scad, tube_mount_couplers.scad, tube_mount_display_2_panel_assembly.scad]
2026-09-20 Default interactive preview to low detail
    [main.scad]
2026-09-20 Use boolean high-resolution preview switch
    [main.scad]
2026-09-20 Split raw and dovetail clamp views
    [dovetail_tube_clamp.scad, main.scad]
2026-09-20 Adopt released clamp fit and dovetail entry APIs
    [display_frame_assembly.scad, dovetail_interface.scad, dovetail_tube_clamp.scad, dovetail_tube_clamp_fit_assembly.scad, tube_mount_couplers.scad, tube_mount_display_2_panel_assembly.scad]
2026-09-20 Align HUB75 tube mount consumers with released APIs
    [display_frame_assembly.scad, dovetail-tube-clamp.scad, main.scad]
2026-09-20 Document released clamp and entry-slot integration
2026-09-20 Restructure HUB75 tube mounts and prototype top-entry clamp
    [corner-edge-coupler-horizontal-profile-section.scad, corner-edge-coupler-left-fit-detail.scad, corner-edge-coupler-left-rear-fit-section.scad, corner-edge-coupler-left-xy-side-edge-section.scad, corner-edge-coupler-left-yz-top-edge-section.scad, corner-edge-coupler-left.scad, corner-edge-coupler-right-fit-detail.scad, corner-edge-coupler-right-rear-fit-section.scad]
2026-09-20 Add local tube-mount assembly views
    [hub75_tube_corner_edge_assembly.scad, main.scad]
2026-09-20 Restore 2 mm tube-mount dovetail and narrow clamp
    [hub75_tube_clamp.scad, tube_mount_interface.scad]
2026-09-20 Use printable dovetail root land and male relief
    [hub75_tube_clamp.scad, tube_mount_interface.scad]
2026-09-20 Chamfer the clamp dovetail relief shoulder
    [hub75_tube_clamp.scad]
2026-09-20 Add mouth land and move tube mount forward
    [hub75_tube_clamp.scad, hub75_tube_corner_edge_coupler.scad, hub75_tube_horizontal_edge_coupler.scad, tube_mount_interface.scad]
2026-09-20 Match clamp relief chamfer to dovetail angle
    [hub75_tube_clamp.scad, tube_mount_interface.scad]
2026-09-20 Align tube front datum and move complete clamp interface forward
    [hub75_tube_clamp.scad, tube_mount_interface.scad]
2026-09-20 Cut horizontal tube-mount female directly into edge connector
    [hub75_tube_horizontal_edge_coupler.scad, hub75_tube_horizontal_edge_coupler_render.scad, tube_mount_interface.scad]
2026-09-20 Keep tube-mount lock tongue flush with host rear face
    [tube_mount_interface.scad]
2026-09-20 Apply direct female cut to corner edge connector
    [hub75_tube_corner_edge_coupler.scad, hub75_tube_horizontal_edge_coupler.scad, hub75_tube_horizontal_edge_coupler_render.scad, tube_mount_interface.scad]
2026-09-20 Cut corner clearance for clamp body
    [hub75_tube_corner_edge_coupler.scad]
2026-09-20 Move corner clamp interface into existing vertical arm
    [hub75_tube_corner_edge_coupler.scad]
2026-09-20 Sweep corner clamp clearance through entry path
    [hub75_tube_corner_edge_coupler.scad]
2026-09-20 Fix corner clamp keepout assertions
    [hub75_tube_corner_edge_coupler.scad]
2026-09-20 Scale tube-mount clamps and adopt mechint v0.1.5
    [dovetail-tube-clamp.scad, hub75_tube_clamp.scad, tube_mount_interface.scad]
2026-09-20 Derive corner keepout transition from enlarged clamp
    [hub75_tube_corner_edge_coupler.scad]
2026-09-20 Document size-matched tube-mount interface
2026-09-20 Smooth clamp transition and clear full corner clip envelope
    [hub75_tube_clamp.scad, hub75_tube_corner_edge_coupler.scad]
2026-09-20 Correct clamp shoulder relief to vertical cylinder
    [hub75_tube_clamp.scad]
2026-09-20 Simplify corner clip insertion envelope
    [hub75_tube_corner_edge_coupler.scad]
2026-09-20 Correct side-print clamp transition relief
    [hub75_tube_clamp.scad]
2026-09-20 Refine clamp relief and corner print clearance
    [hub75_tube_clamp.scad, hub75_tube_corner_edge_coupler.scad]
2026-09-21 Fix clamp profile binding and relief
    [hub75_tube_clamp.scad, main.scad]
2026-09-21 Document HUB75 clamp design and restore baseline
    [hub75_tube_clamp.scad, hub75_tube_clamp_render.scad]
2026-09-21 Fix clamp design render source
2026-09-21 Link clamp source to its design
    [hub75_tube_clamp.scad]
2026-09-21 Keep clamp body fixed across profiles
    [hub75_tube_clamp.scad, hub75_tube_clamp_render.scad]
2026-09-21 Namespace clamp standalone preview
    [hub75_tube_clamp.scad]
2026-09-21 Explain clamp transition sizing tradeoff
2026-09-21 Add print-vertical clamp transition fillet
    [hub75_tube_clamp.scad, hub75_tube_clamp_render.scad]
2026-09-21 Use print-vertical round clamp relief
    [hub75_tube_clamp.scad, hub75_tube_clamp_render.scad]
2026-09-21 Move clamp relief to lower transition foot
    [hub75_tube_clamp.scad, hub75_tube_clamp_render.scad]
2026-09-21 Adopt validated clamp side relief
    [hub75_tube_clamp.scad, hub75_tube_clamp_render.scad]
2026-09-21 Remove clamp standalone preview harness
    [hub75_tube_clamp.scad]
2026-09-21 Document clamp render separation
2026-09-21 Restore clear standalone clamp controls
    [hub75_tube_clamp.scad]
2026-09-21 Clarify clamp standalone control naming
2026-09-21 Prefix standalone clamp Customizer controls
    [hub75_tube_clamp.scad]
2026-09-21 Use menu prefix for standalone controls
    [hub75_tube_clamp.scad]
2026-09-21 Fix standalone menu control names
    [hub75_tube_clamp.scad]
2026-09-21 Use mi prefix for Customizer menu items
    [hub75_tube_clamp.scad]
2026-09-21 Limit mi prefix to presentation state
    [hub75_tube_clamp.scad]
2026-09-21 Adopt shared SCAD naming convention
    [hub75_tube_clamp.scad]
2026-09-21 Integrate mechint v0.1.6 printable lock release
    [hub75_tube_clamp.scad, tube_mount_interface.scad]
2026-09-21 refactor(scad): migrate HUB75 to mechint coding-standard API
    [tube_mount_interface.scad]
2026-09-21 chore(scad): pin qualified mechint coding-standard head
2026-09-21 chore(scad): pin released util and mechint stack
2026-09-21 chore(scad): pin latest released util and mechint stack
2026-09-22 refactor(scad): adopt Forge transforms
    [hub75_tube_clamp.scad]
2026-09-22 chore(scad): pin mechint v0.2.2 Forge stack
2026-09-22 chore(scad): adopt mechint v0.2.3 public API
    [hub75_tube_clamp.scad, tube_mount_interface.scad]
2026-09-22 docs(scad): align orientation terminology
    [hub75_tube_clamp.scad, hub75_tube_clamp_render.scad]
2026-09-22 refactor(scad): adopt Forge resolution baseline
    [display_frame_assembly.scad, dovetail-tube-clamp.scad, hub75_tube_clamp.scad, hub75_tube_clamp_render.scad, hub75_tube_corner_edge_assembly.scad, hub75_tube_horizontal_edge_assembly.scad, main.scad, tube_mount_display_2_panel_assembly.scad]
2026-09-22 fix(scad): complete resolution rename
    [hub75_tube_horizontal_edge_fit_assembly.scad, main.scad]
2026-09-22 refactor(scad): align tube-mount project API with coding standard
    [aluminium_tube.scad, corner-edge-tube-mount-coupler-left.scad, corner-edge-tube-mount-coupler-right.scad, display_frame_assembly.scad, horizontal-edge-tube-mount-coupler.scad, hub75_corner_edge_coupler.scad, hub75_horizontal_edge_coupler.scad, hub75_horizontal_edge_coupler_render.scad]
2026-09-22 fix(scad): complete tube-mount caller migration
    [horizontal-edge-tube-mount-lock-section.scad, horizontal-edge-tube-mount-yz-section.scad, hub75_tube_horizontal_edge_assembly.scad, hub75_tube_horizontal_edge_coupler_render.scad]
2026-09-22 fix(scad): preserve multi-size build matrix input
    [corner-edge-tube-mount-coupler-left.scad, corner-edge-tube-mount-coupler-right.scad, dovetail-tube-clamp.scad, horizontal-edge-tube-mount-coupler.scad]
2026-09-22 refactor(scad): align standalone source surfaces
    [corner-edge-coupler-left.scad, corner-edge-coupler-right.scad, horizontal-edge-coupler.scad, hub75_corner_edge_coupler.scad, hub75_corner_edge_coupler_render.scad, hub75_horizontal_edge_coupler.scad, hub75_horizontal_edge_coupler_render.scad, hub75_middle_coupler.scad]
2026-09-22 chore(scad): gate unfinished tube-mount integration
    [display_frame_assembly.scad, main.scad]
2026-09-22 chore: pin tool.scad-project v0.15.8
2026-09-22 Fix panel orientation and restore rear data-chain labels (#46)
    Define rear-view panel numbering/orientation from the data chain, restore optional panel numbers and IN/OUT labels, expose the controls in project assemblies, and add rear-wiring build evidence.
    [display_frame_assembly.scad, main.scad, panels_assembly.scad, rear-wiring.scad, tube_mount_display_2_panel_assembly.scad]
2026-09-22 Targeted Forge cleanup for HUB75 CAD (#53)
    Use Forge frames, cutters and tagged CSG where they clarify project-owned CAD intent while preserving geometry and existing overlap behavior.
    [hub75_corner_edge_coupler.scad, hub75_horizontal_edge_coupler.scad, hub75_middle_coupler.scad, hub75_tube_clamp.scad, hub75_tube_corner_edge_coupler.scad, hub75_tube_horizontal_edge_coupler.scad]
2026-09-22 Correct STL export print orientations (#54)
    Move print orientation ownership to the export/manufacturing boundary, export couplers rear-face-down, and export the detachable tube clamp in its qualified side-print orientation.
    [corner-edge-coupler-left.scad, corner-edge-coupler-right.scad, corner-edge-tube-mount-coupler-left.scad, corner-edge-tube-mount-coupler-right.scad, dovetail-tube-clamp.scad, export_orientation.scad, horizontal-edge-coupler.scad, horizontal-edge-tube-mount-coupler.scad]
2026-09-22 Use semantic names for SCAD domain objects (#57)
    [aluminium_tube.scad, corner-edge-coupler-horizontal-profile-section.scad, corner-edge-coupler-left-fit-detail.scad, corner-edge-coupler-left-rear-fit-section.scad, corner-edge-coupler-left-xy-side-edge-section.scad, corner-edge-coupler-left-yz-top-edge-section.scad, corner-edge-coupler-left.scad, corner-edge-coupler-right-fit-detail.scad]
2026-09-23 Make SCAD placement and CSG intent explicit (#58)
    [aluminium_tube.scad, corner_edge_coupler_fit_assembly.scad, corner_edge_coupler_profile_sections.scad, display_frame_assembly.scad, horizontal_edge_coupler_fit_assembly.scad, hub75_corner_edge_coupler.scad, hub75_corner_edge_coupler_render.scad, hub75_horizontal_edge_coupler.scad]
2026-09-23 Apply Migration 010 application audit findings (#60)
    [hub75_corner_edge_coupler.scad, hub75_horizontal_edge_coupler.scad, hub75_middle_coupler.scad, hub75_tube_clamp.scad, hub75_tube_horizontal_edge_coupler.scad]
2026-09-23 fix: use Forge default cutter overlap (#64)
    [aluminium_tube.scad]
